cyx3705/2025-002/b-Office/对比分析报告.pptx

标题

·

制作人 王小明

Prepared by AIR-Tech@ 11/4/2025 3:30:31 PM

## Slide 2

目录

主要设计的对比

设计的优势

设计的劣势

## Slide 3

主要设计对比

·

Prepared by AIR-Tech@ 11/4/2025 3:30:32 PM

## Slide 4

主要设计对比

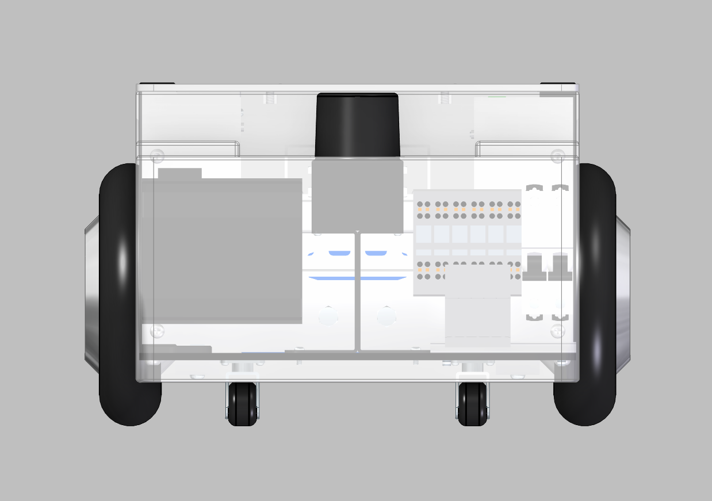
[picture p3: figure]
图片包含 游戏机, 电脑, 桌子, 街道 AI 生成的内容可能不正确。
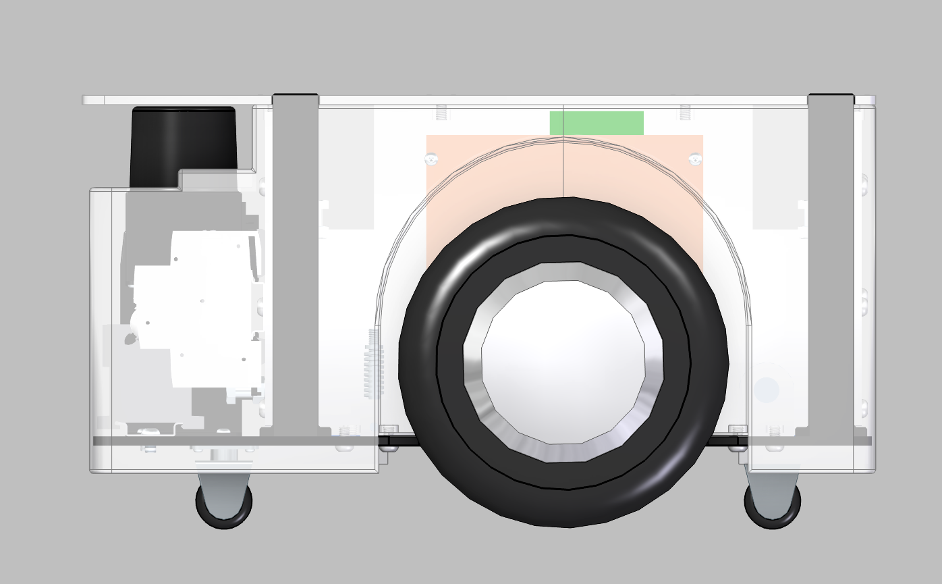
[picture p4: figure]
图片包含 游戏机, 照片, 话筒, 镜子 AI 生成的内容可能不正确。

此为小车三维视图与
小车整体样式，
注意：此时外壳设置为透明只是为方便观察到内部设计和样式，方便对比分析，实物使用的是铝合金外壳

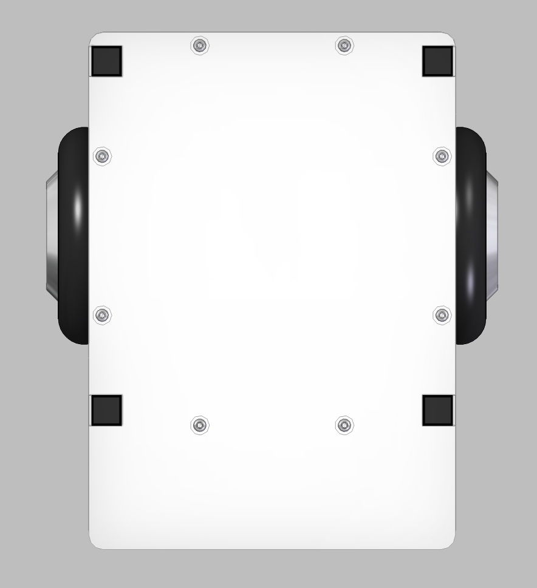
[picture p5: figure]
文本, 白板 AI 生成的内容可能不正确。
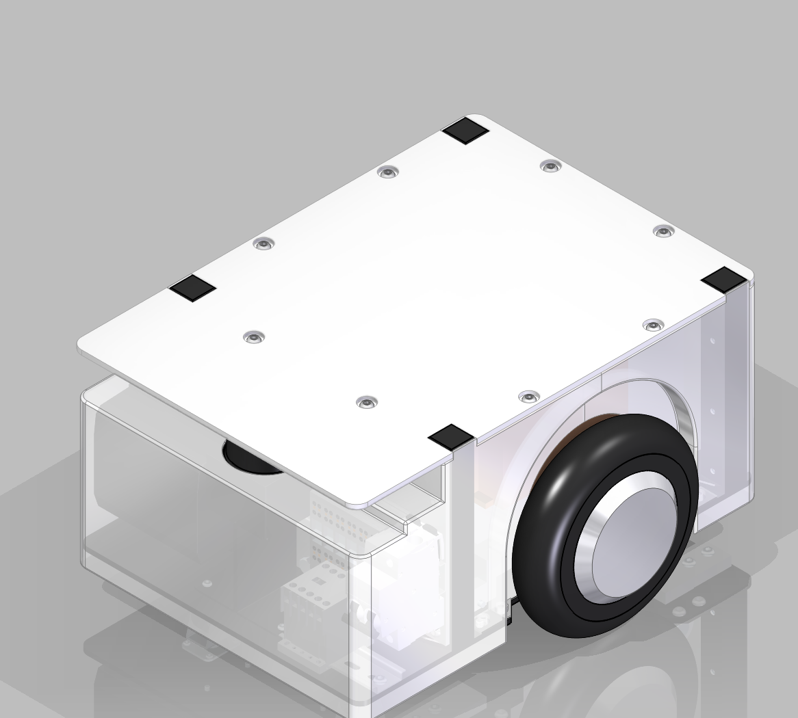
[picture p6: figure]
电子仪器 AI 生成的内容可能不正确。

## Slide 5

主要设计对比

此为小车三维大小图形对比

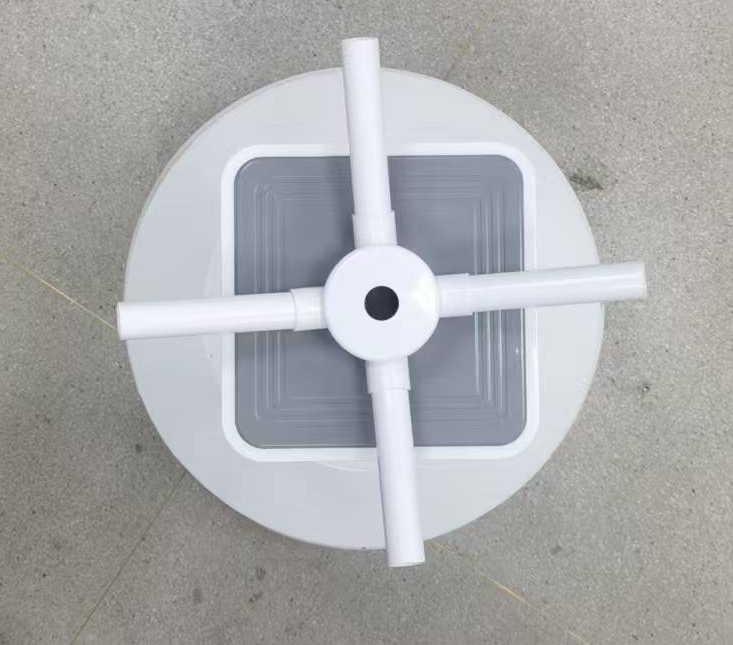
[picture p7: figure]
房间的摆设布局 AI 生成的内容可能不正确。
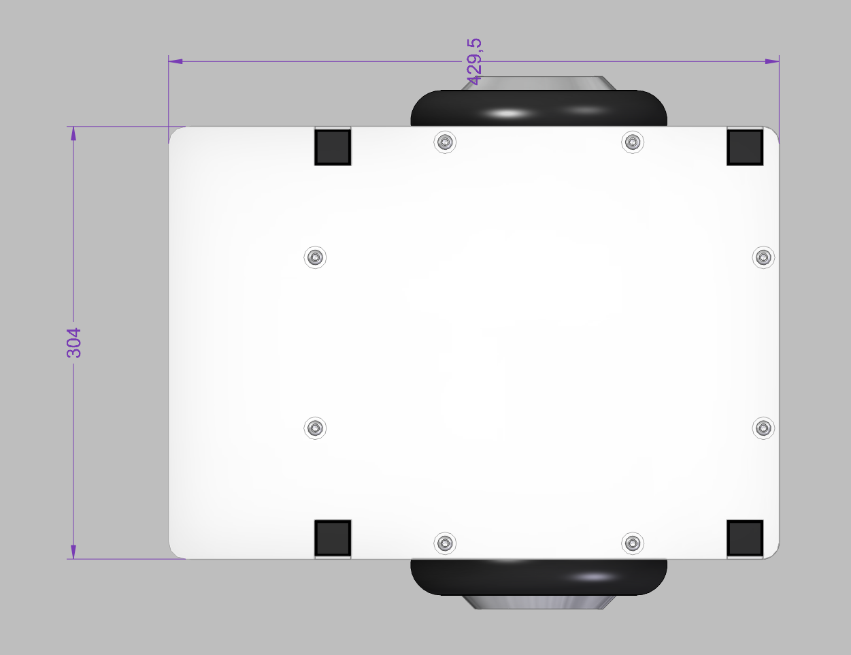
[picture p8: figure]
文本, 白板 AI 生成的内容可能不正确。

500的直径

## Slide 6

主要设计对比

此为小车三维大小图形对比

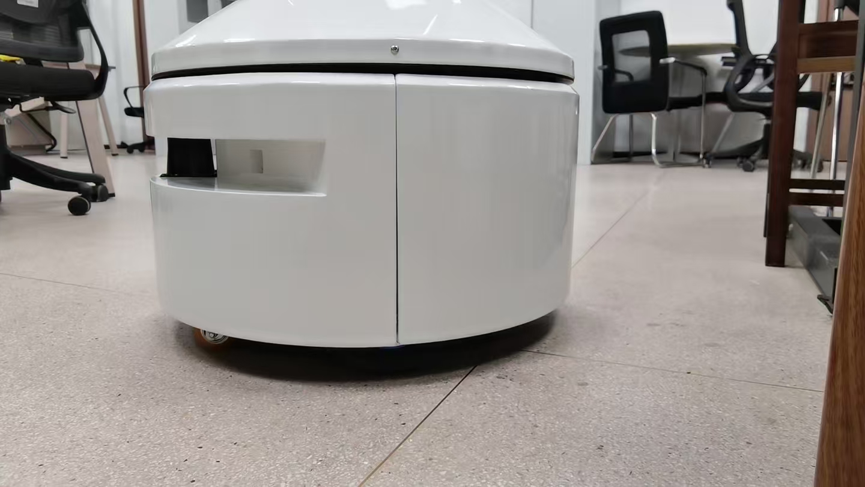
[picture p9: figure]
图片包含 室内, 桌子, 猫, 前 AI 生成的内容可能不正确。
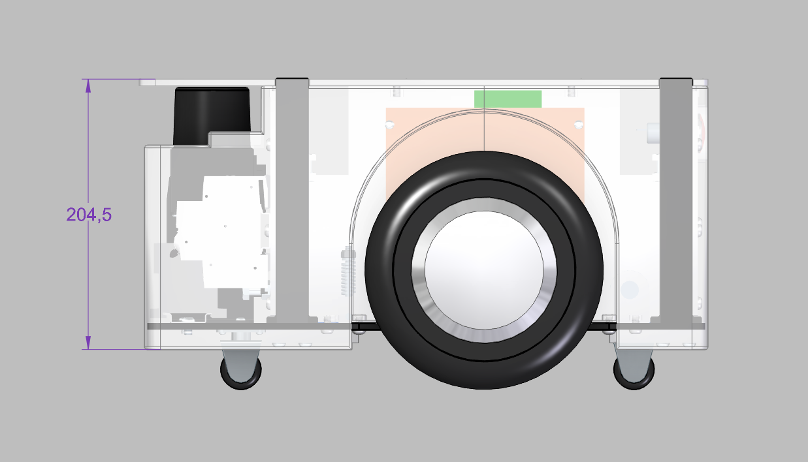
[picture p10: figure]
社交网络的手机截图 AI 生成的内容可能不正确。

250的高

## Slide 7

主要设计对比

此为小车内部结构的对比

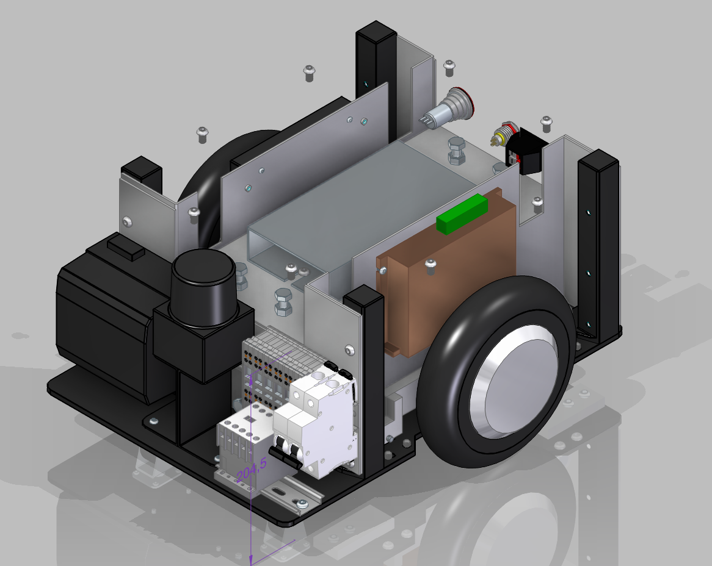
[picture p11: figure]
图片包含 乐高, 玩具, 室内, 桌子 AI 生成的内容可能不正确。

我们设计的布局紧凑结构合理

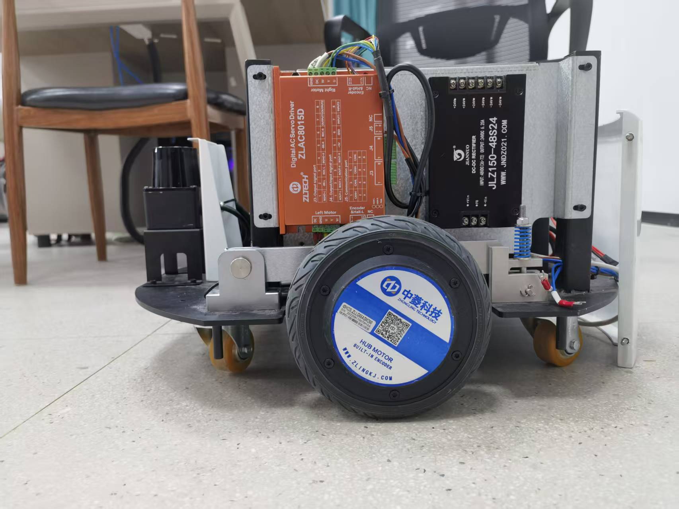
[picture p12: figure]
桌子上放着几个行李箱 AI 生成的内容可能不正确。

原先的较多空间浪费

## Slide 8

主要设计对比

此为小车内部结构的对比

原先的设计使用螺栓进行锁紧并提供纵向拉力，所有力汇集
到螺栓上面，受力非常不合理
我们的设计使用悬挂直接与底板解除传导力，受力合理

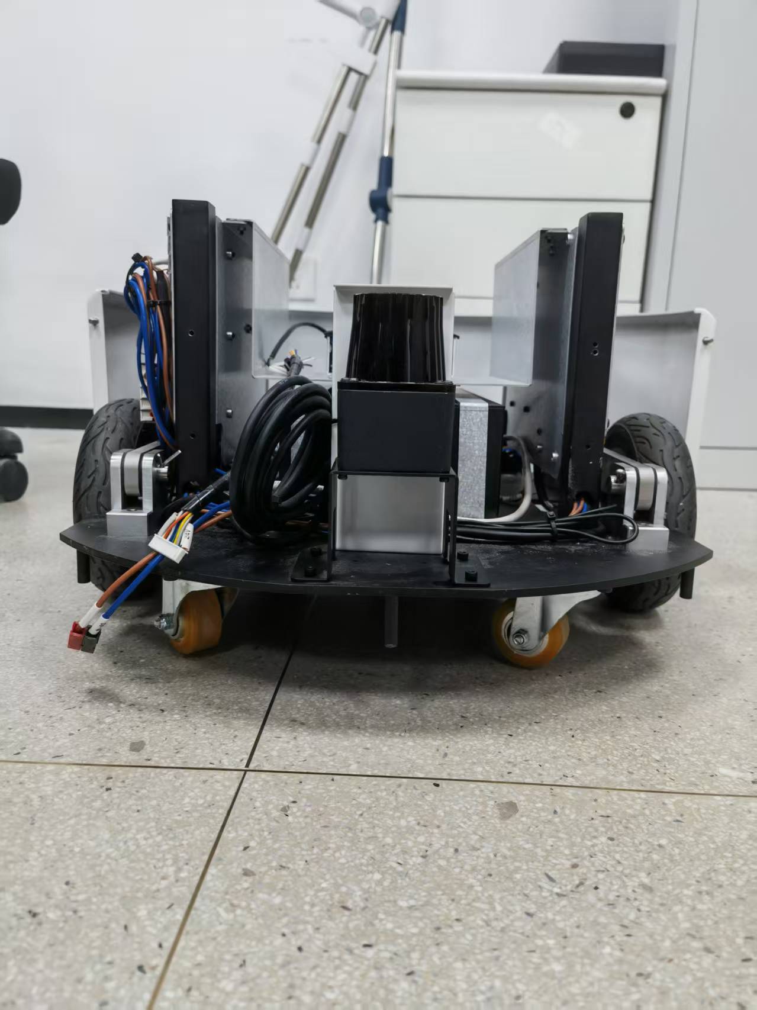
[picture p13: figure]
图片包含 户外, 卡车, 男人, 大 AI 生成的内容可能不正确。
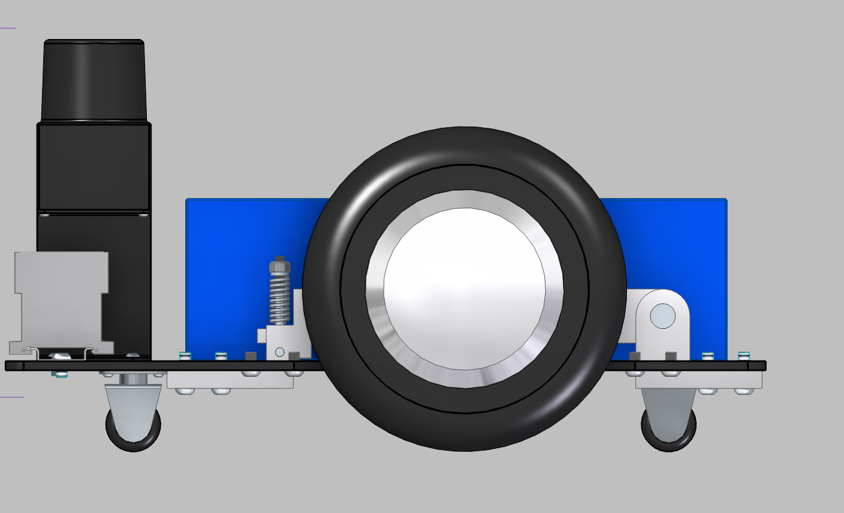
[picture p14: figure]
图片包含 游戏机, 电子, 话筒, 桌子 AI 生成的内容可能不正确。

## Slide 9

主要设计对比

此为小车顶部空间利用对比

本设计底部螺丝直接与外壳相连接，总体安装比右图红圈标注的地方的螺母连接更易连接（本设计还有很多有代表性的这类设计，只是使用这一典型设计做声明）

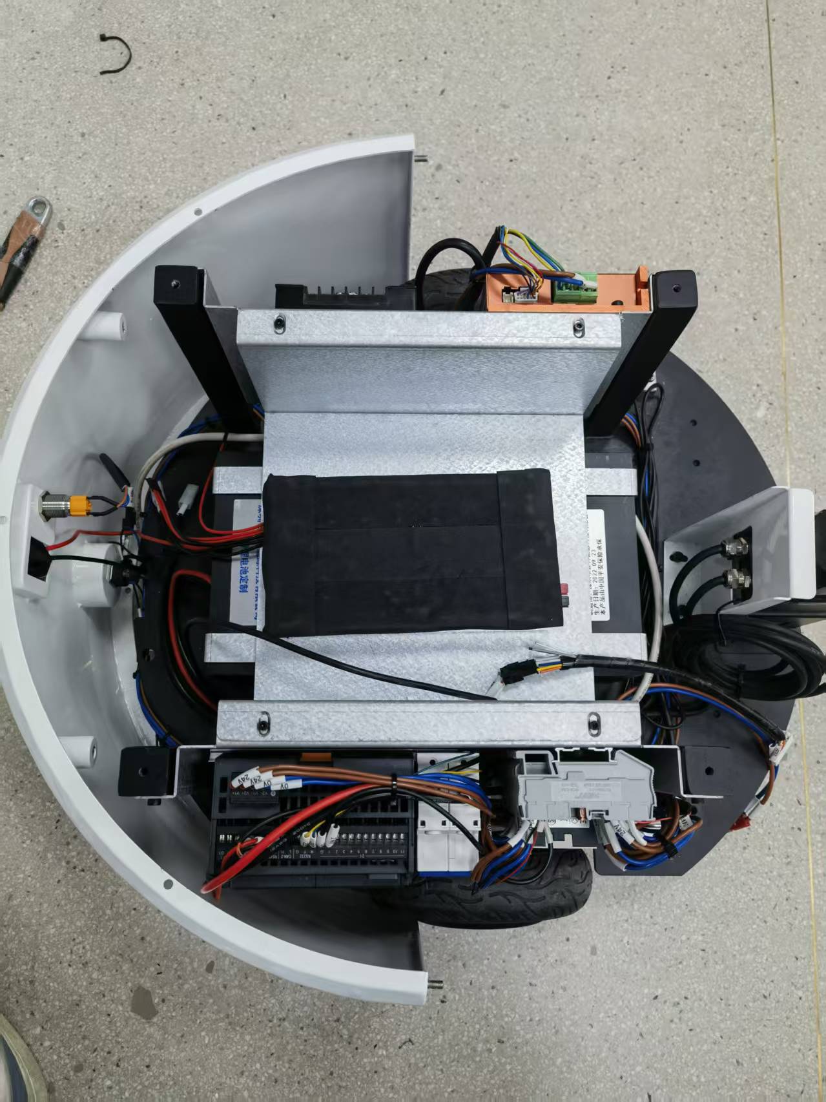
[picture p15: figure]
桌子上的自行车 AI 生成的内容可能不正确。
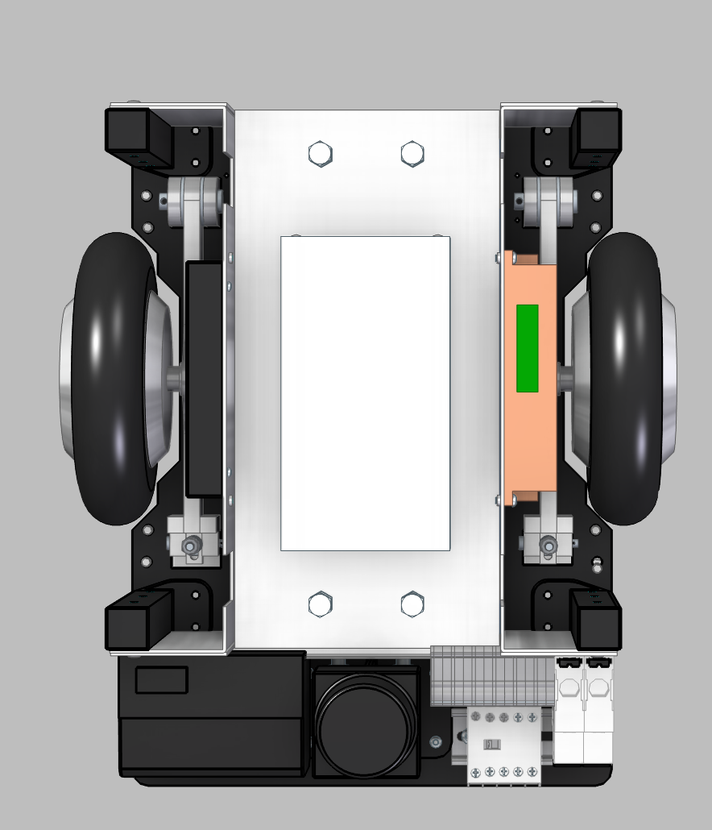
[picture p16: figure]
图形用户界面 AI 生成的内容可能不正确。
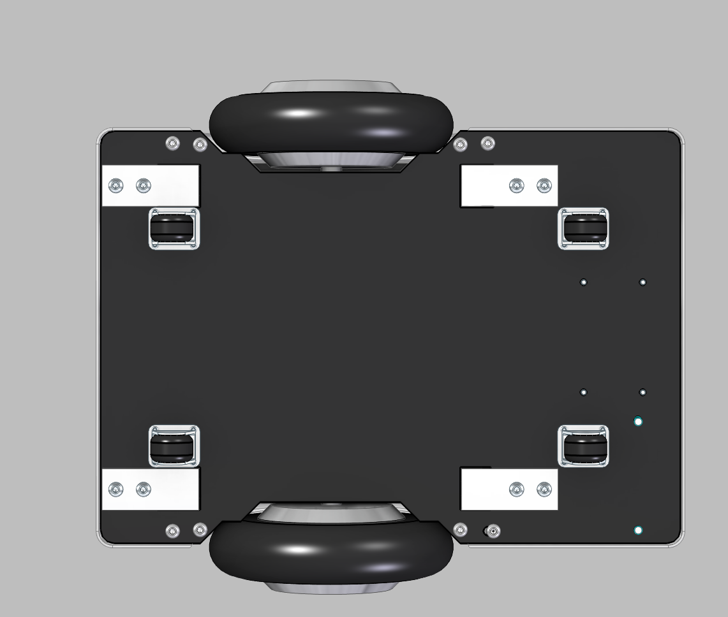
[picture p17: figure]
图形用户界面 AI 生成的内容可能不正确。

## Slide 10

设计的优势

·

Prepared by AIR-Tech@ 11/4/2025 3:30:32 PM

## Slide 11

设计的优势

1.根据前面的对比已经知道本设计使用的结构使得整体体积下降1.8倍250*250*250*3.14/(430*304*200)=1.8

2.不仅螺栓受力更合理，而且支撑架的受力同样更合理
悬挂的顶部直接是支撑架，底盘不传导车体本身重量以外的其他力是非承载式底盘。

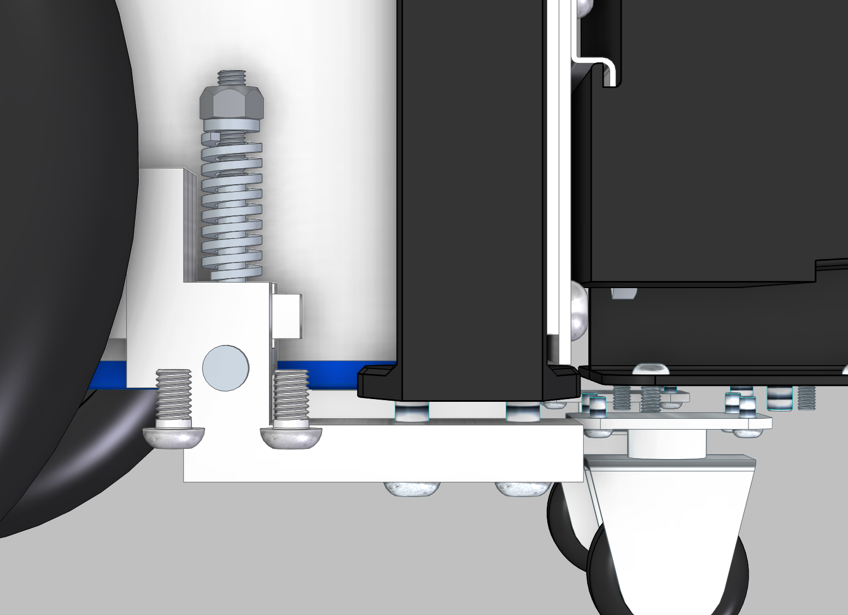
[picture p18: figure]
图形用户界面 AI 生成的内容可能不正确。

## Slide 12

设计的优势

2.本设计中电池是直接使用支撑螺丝固定在板材上面的而非使用钢条绑定在底盘上面，这样的设计更加简单便宜因为固定螺栓使用的是标准件，并且整体受力是多个方向的支持力比原先使用支持力和摩擦力的合力要更好。整车的一体性要明显更好！

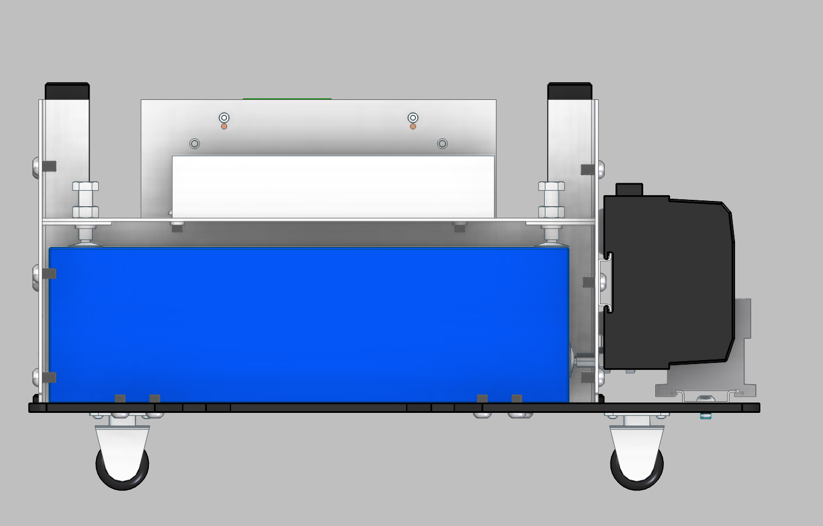
[picture p19: figure]
图形用户界面 AI 生成的内容可能不正确。

## Slide 13

设计的劣势

·

Prepared by AIR-Tech@ 11/4/2025 3:30:32 PM

## Slide 14

设计的劣势

2.本设计唯一相比原先的设计的劣势是，由于需要压缩体积，导致雷达的扫描范围有小部分减少，但基本上不影响使用，本车的雷达也是完全暴露的。

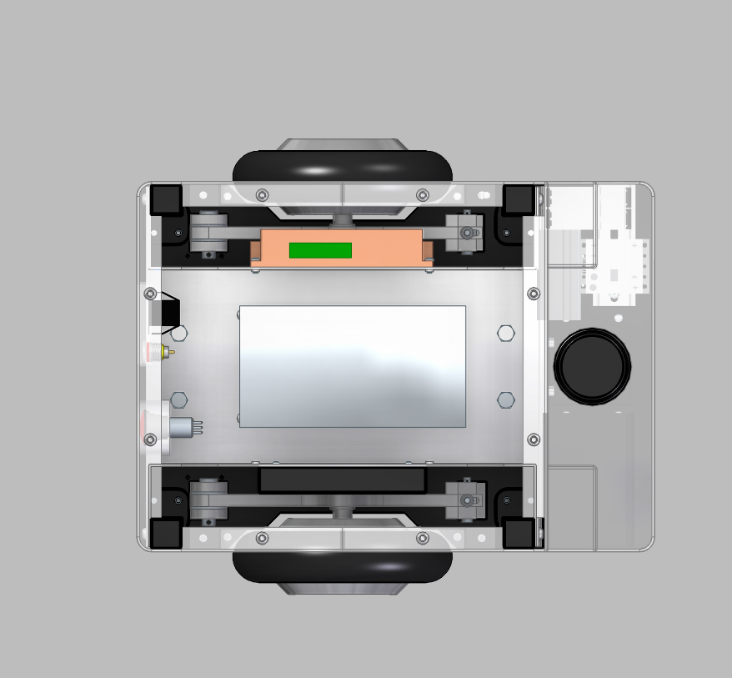
[picture p20: figure]
图片包含 游戏机, 卡车, 男人, 床 AI 生成的内容可能不正确。

盲区
