cyx3705/2025-002/b-EPLAN/AGV.edb/Images/2.png

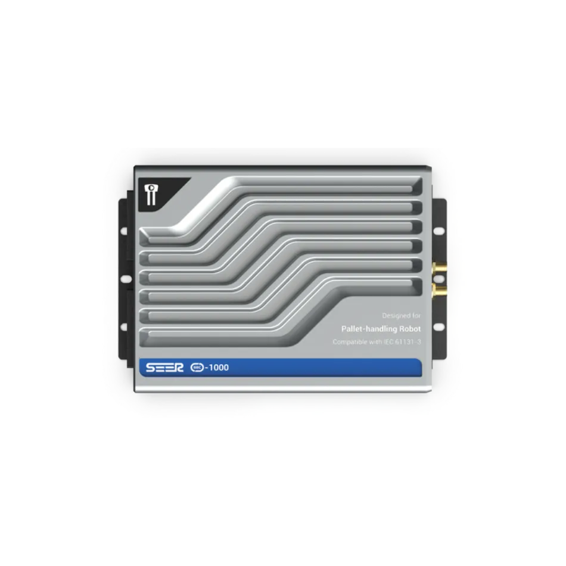
b-EPLAN/AGV.edb/Images/2.png
