cyx3705/2025-002/b-EPLAN/AGV.edb/Images/CRC3000.png

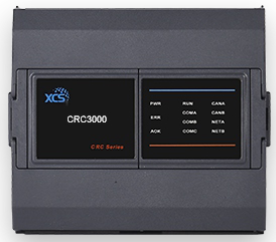
b-EPLAN/AGV.edb/Images/CRC3000.png
