cyx3705/2025-002/b-Office/BOM表.xlsx

Sheet: Revision History
Revision 版本 | Description 变更描述 | Date 变更日期 | Updated BY 变更人 | Remarks 备注
1.01 | 更换仙工的控制器，增加接口转换模块 | 2025-11-20 | 夏姜楠
1.02 | 删除冗余变频器，修改轮毂选型,完善设备完整度（新增急停按钮和启动按钮） | 2025-11-28 | 夏姜楠

Sheet: BOM模板
 | Product Name 成品名称 |  | DOC. Number 文件编号 |  | Rev. 版本号 |  |  | Updated BY 更新人 |  | Checked BY 审核人 |  | Approved BY 批准人
 |  |  | BOM-503TWM0203 |  | 1.02
 |  |  |  |  |  |  |  | Date 日期 |  | Date 日期 |  | Date 日期
 |  |  | Initial Date 初版日期
Item 序号 | 文档号 | Description 名称 | Specification 参数描述 | Manufacturer 制造商 |  | RoHS 有毒 元素 控制 | QTY 数量 | Unit 单位 | Substitute P/N 替代料P/N | Remarks 备注 | EPDM Auto EPDM自动导出 | Optimized 优选等级 | Unit Price 单价(RMB) | Subtotal 合计(RMB)
 |  |  |  | Model No. 型号 | Brand 品牌
1 | N2531-2113 | 变压器 | input:48VDC output:24VDC 6.25A | JLZ150-48S24 | JIANNUO |  | 1
1 | N2531-2112 | 伺服驱动器 | input:48VDC output:均值15VDC 峰值30A | ZLAC8015D | ZLTECH |  | 1
2 | N2531-1411 | 雷达 | 2D导航激光 | H1E0-02C | 仙工 |  | 1
3 | N2531-0121 | 后外壳 |  |  |  |  | 1
4 | N2531-0122 | 前外壳 |  |  |  |  | 1
5 | N2531-0123 | 顶板 |  |  |  |  | 1
6 | N2531-1111 | 电池 | 标称电压：48V 充电电压：54.6V 标称容量：20Ah 放电电流：<=30A | LS-DL48-20C | 深圳市锂神能源科技有限公司 |  | 1
7 | N2531-1121 | 底盘主体 |  |  |  |  | 1
8 | N2531-1211 | 6.5寸轮毂带编码器机器人轮毂伺服 | M170 48V 250W 4N.m IP65 | ZZLG65ASM250 V3.0 | 中菱科技 |  | 2
9 | N2531-1221 | 前桥 |  |  |  |  | 2
10 | N2531-1222 | 后桥 |  |  |  |  | 2
11 | N2531-1223 | 梁 |  |  |  |  | 2
12 | N2531-1311 | 轮毂架 |  |  | RichLand |  | 4
13 | N2531-1312 | 辅助轮 |  |  | RichLand |  | 4
14 | N2531-2111 | 电箱din导轨300 | 296mm |  |  |  | 1
15 | N2531-2121 | 安装板 |  |  |  |  | 1
16 | N2531-2122 | 架子 |  |  |  |  | 1
17 | N2531-2123 | 挡板 |  |  |  |  | 1
18 | N2531-2221 | 上安装板 |  |  |  |  | 1
19 | N2531-0111 N2531-2115 N2531-1513 N2531-2211 | 内六角平圆头螺钉 | M6*10 | GBT70.2-2015 |  |  | 33
20 | N2531-1412 N2531-2117 | 内六角平圆头螺钉 | M4*10 | GBT70.2-2015 |  |  | 6
21 | N2531-2116 | 内六角平圆头螺钉 | M3*10 | GBT70.2-2015 |  |  | 2
22 | N2531-1313 N2531-1413 | 内六角平圆头螺钉 | M3*6 | GBT70.2-2015 |  |  | 20
23 | N2531-2400 | 紧固螺丝组 | M8*50 |  |  |  | 6
24 | N2531-1212 | 销 | M5*34 |  |  |  | 2
25 | N2531-1213 | 大垫圈 | D30 d10 |  |  |  | 4
26 | N2531-1214 | 小垫圈 | D10 d6 |  |  |  | 4
27 | N2531-1215 | 平头圆柱销 | M10*36 |  |  |  | 2
28 | N2531-1216 | 六角锁紧螺母 | M6 | GBT6184-2000 |  |  | 2
29 | N2531-1217 | 内六角平圆头螺钉 | M6*20 | GBT70.2-2015 |  |  | 8
30 | N2531-1225 | 减震器 |  |  |  |  | 2
31 | N2531-1218 | 弹簧 | D10 d5 H20 |  |  |  | 2
32 | N2531-1421 | 雷达安装板 |  |  |  |  | 1
33 | N2531-211B | 接触器 | TeSys K 直流控制三极接触器, 12A, 24 V DC | LP1K1210DB | 施耐德 |  | 1
34 | N2531-1512 | 电箱din导轨100 |  |  |  |  | 1
35 | N2531-2118 | 移动机器人导航控制器 |  | SRC-880-t | 仙工 |  | 1
36 | N2531-211A | 接线端子 |  | PT2.5-QUATTRO灰色 |  |  | 12
37 | N2531-2119 | 空开 |  | IC60a | 施耐德 |  | 2
38 | N2531-211C | RS-232/485转CAN BUS协议转换器 | RS232/485转CANBUS | UT-2506A | 宇泰 |  | 1
39 | N2531-211D | 语音提示器 |  |  |  |  | 1
40 | N2531-211E | 急停开关 |  | YJ-LA16-11ZS 红 | 一佳 |  | 1
41 | N2531-211F | 开关按钮 |  | LB16A/19A铝氧化 | 蓝波 |  | 1
42 |  | 触摸屏 | 384*247 | TPC1570Gn | 昆仑通态
43
44
45
46
注： |  | 为加工件
 |  | 为采购件
