cyx3705/2025-002/b-Module-GE/0000-DJJ-12-5.stp

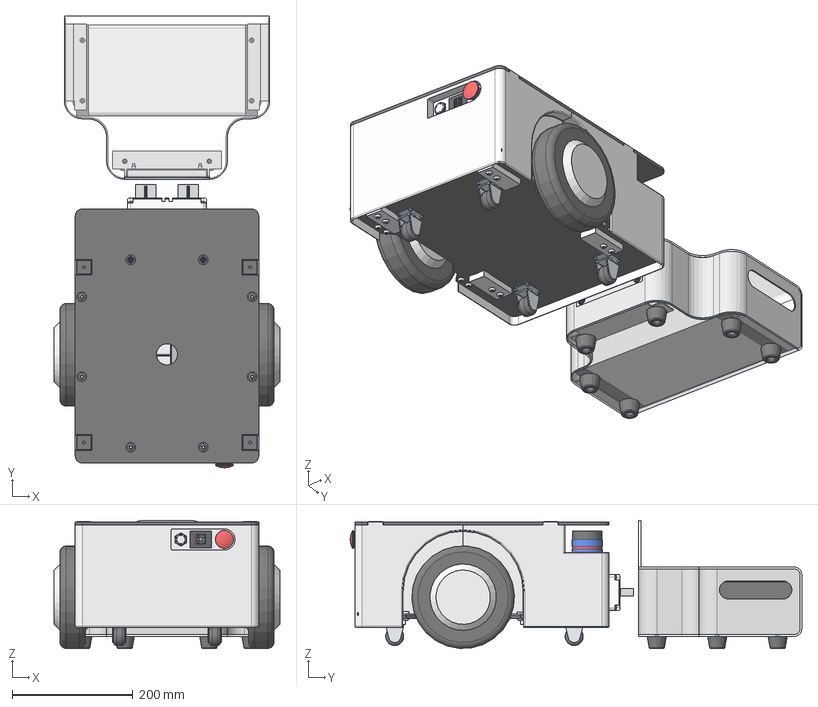
[picture p38: CAD file, 2026-09-21]
b-Module-GE/0000-DJJ-12-5.stp
374.0 x 747.5 x 212.0 mm
1311-謫嘎 x 4
1312-謫 x 4
1313-内六角平圆头螺钉-GBT70.2-20 x 16
1221-ǰ x 2
1222-綴Э x 2
1223-褽 x 2
1217-内六角平圆头螺钉-GBT70.2-201 x 8
1224-熬涾 x 2
1213-湮菜 x 4
1212-种 x 2
1214-苤菜 x 4
1211-轮瓙 x 2
1218-粟 x 2
1216-1型全金属六角锁紧螺母-GBT618 x 2
1215-ﾆｽﾍｷﾔｲﾄ x 2
1121-菁攫
0111-内六角平圆头螺钉-GBT70.2-201 x 18
1111-萇
2121-假蚾 x 2
2123-結 x 2
2122-ｼﾜntationRefs x 4
SB105175_3D-SOFTWARE_COLOUR
2115-内六角平圆头螺钉-GBT70.2-201 x 12
2125-PT2.5-QUATTRO灰色（万特弗t x 12
2125-PT2.5-QUATTRO灰色隔断板（万 x 6
2119-諾羲 zz x 2
2111-电箱din导轨
2221-奻假
2211-内六角圆柱头螺钉-GBT70.1-20饳扑 x 6
2214-濘
2213-内六角圆柱头螺钉-GBT70.1-200 x 4
2117-曹揤v褊
2222-濘湛假efs
2212-SRC-1X00-CN
2116-ﾋﾅｷﾇﾋ
2215-内六角圆柱头螺钉-GBT70.1-20T x 2
2216-内六角圆柱头螺钉-GBT70.1-20 x 4
2217-内六角圆柱头螺钉-GBT70.1-20R x 2
0123-ｶ･ntationRefs
0122-ﾇｰﾍ穢Xﾊ
0121-綴俋
0116-内六角平圆头螺钉-GBT70.2-201 x 4
0112-YJ-LA16-11ZS
0115-323769099450A横向刷板9
0113-带卡胶壳-147
0114-懦疏LB16
0221-菁
0211-原装充电UY1
0212-脚氶拤 x 4
0222-旳啣
0213-内六角圆柱头螺钉-GBT70.1-200 x 6
IFCBUILDINGELEMENTPROXY.ifc
0214-内六角圆柱头螺钉-GBT70.1-200 x 4
