cyx3705/2025-002/b-EPLAN/AGV.pdf

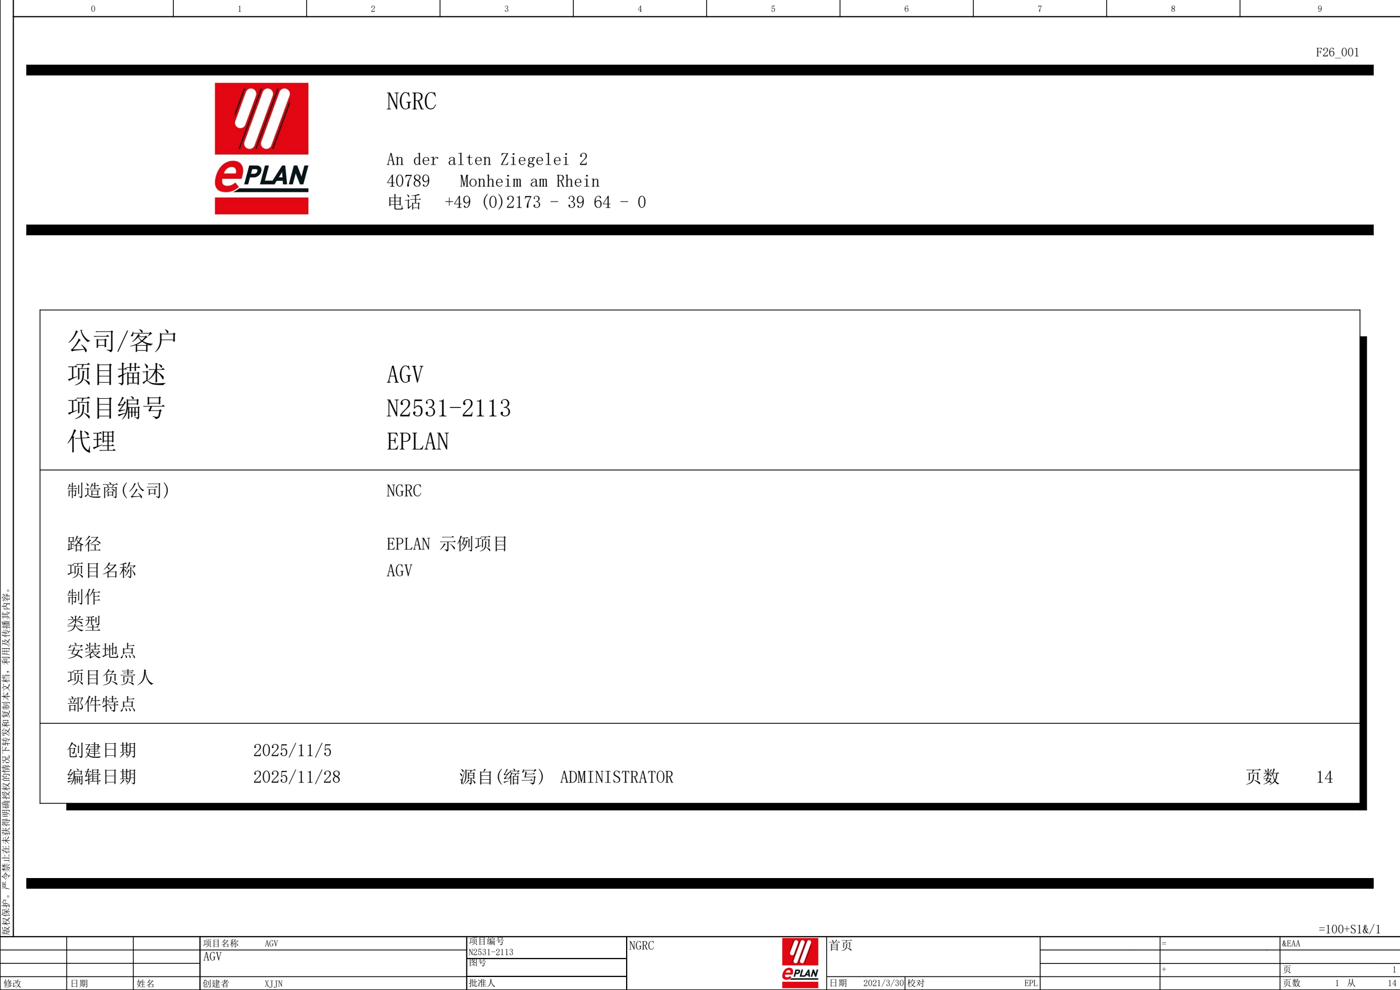
[picture p40: figure]
AGV; EPL 1; NGRC; &EAA; 批准人; 项目名称; 项目编号; 创建者; XJJN; 版权保护。严令禁止在未获得明确授权的情况下转发和复制本文档，利用及传播其内容。; 项目描述; 编辑日期; 创建日期; EPLAN 示例项目; ADMINISTRATOR; 部件特点; An der alten Ziegelei 2; 制造商(公司); 项目负责人; 安装地点; EPLAN; Monheim am Rhein

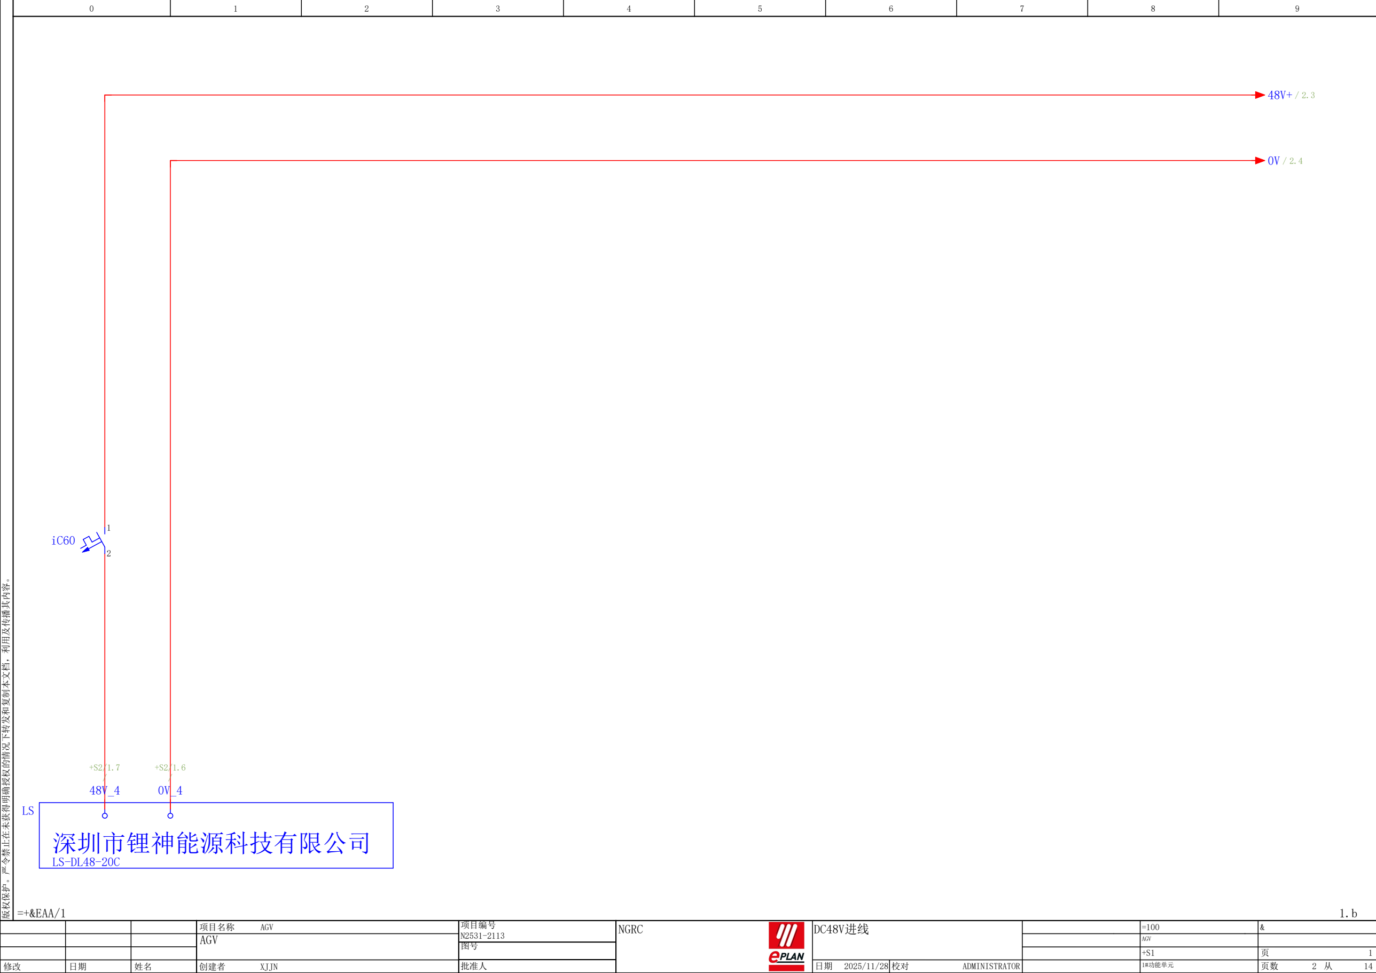
[picture p41: figure]
=+&EAA/1; ADMINISTRATOR; DC48V进线; 1#功能单元; 版权保护。严令禁止在未获得明确授权的情况下转发和复制本文档，利用及传播其内容。; 深圳市锂神能源科技有限公司

ES-7-5

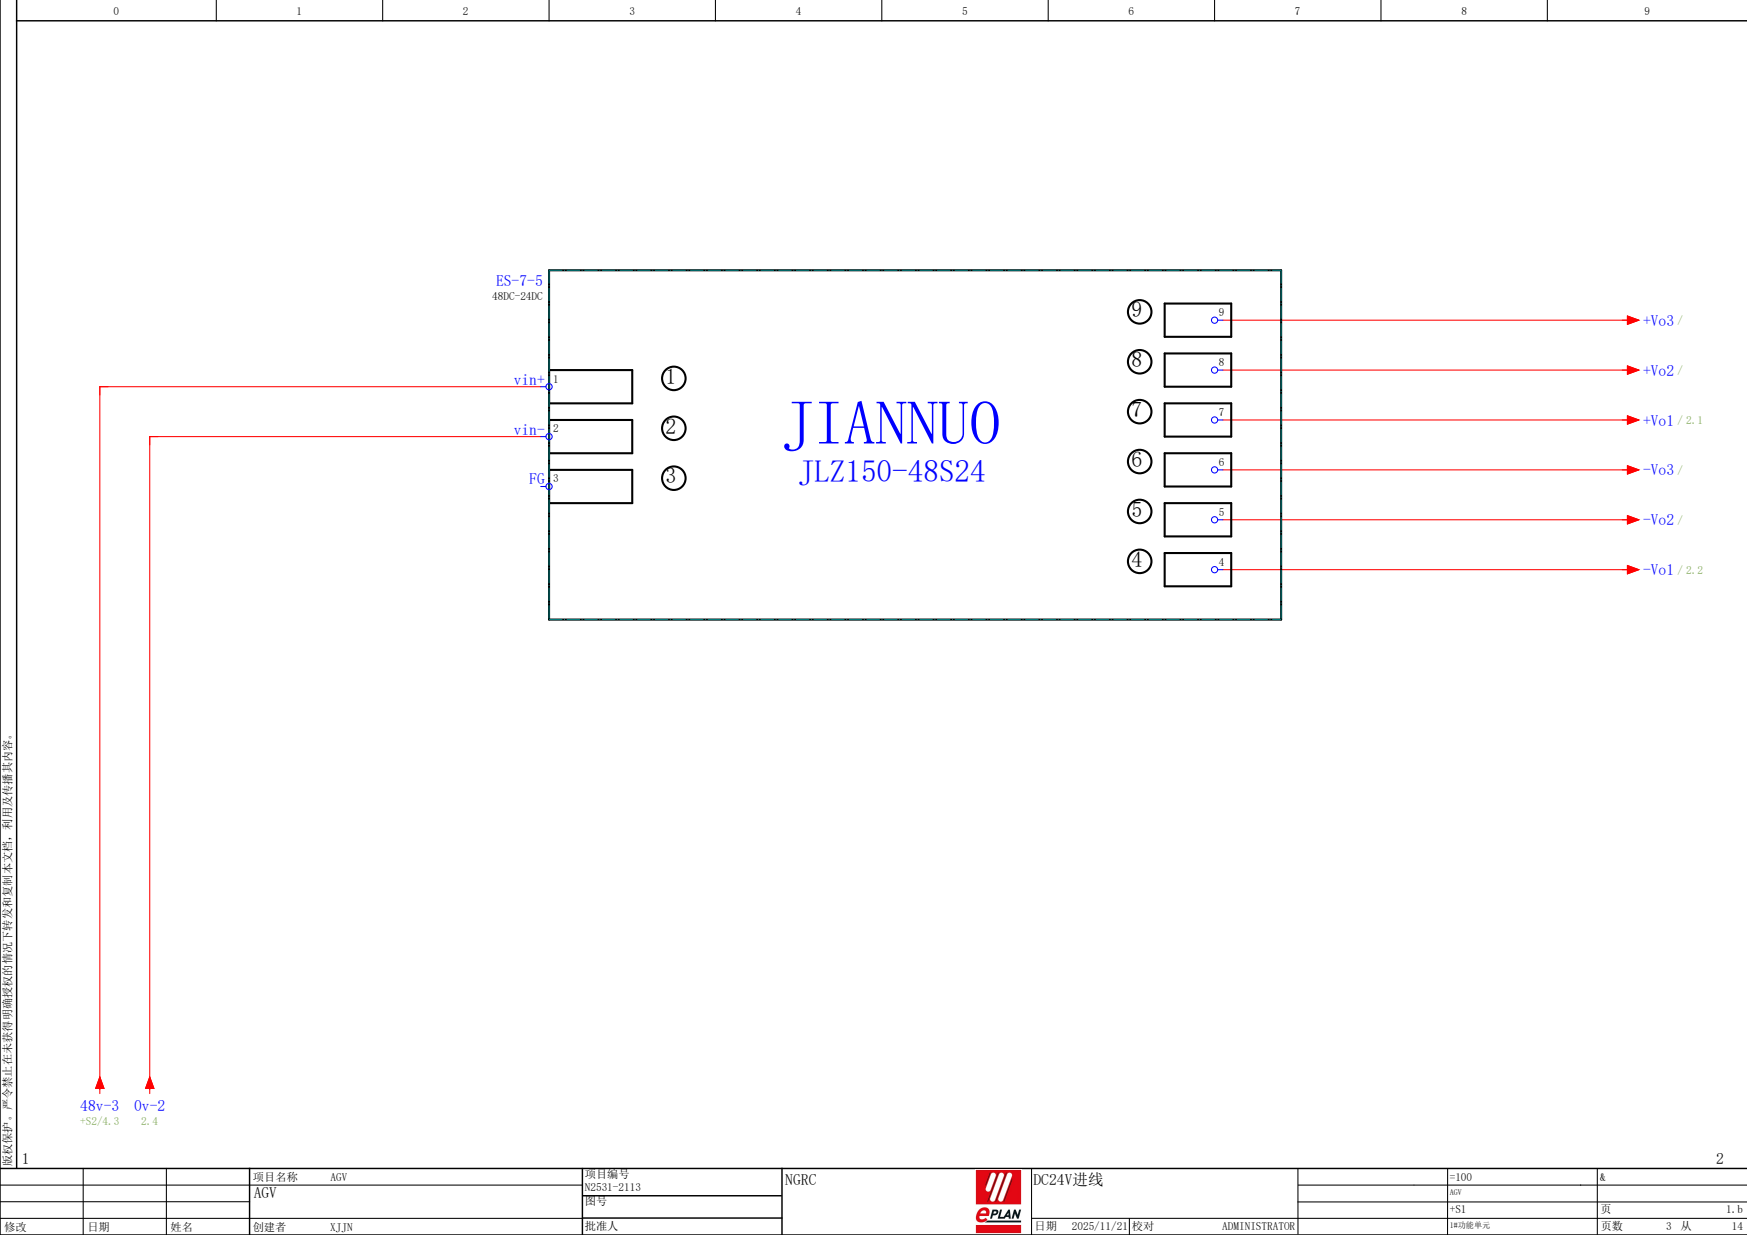
[picture p42: page 3]
ADMINISTRATOR 1; DC24V进线; JLZ150-48S24; JIANNUO; vin+; vin-

版权保护。严令禁止在未获得明确授权的情况下转发和复制本文档，利用及传播其内容。

48V-4

0V-4

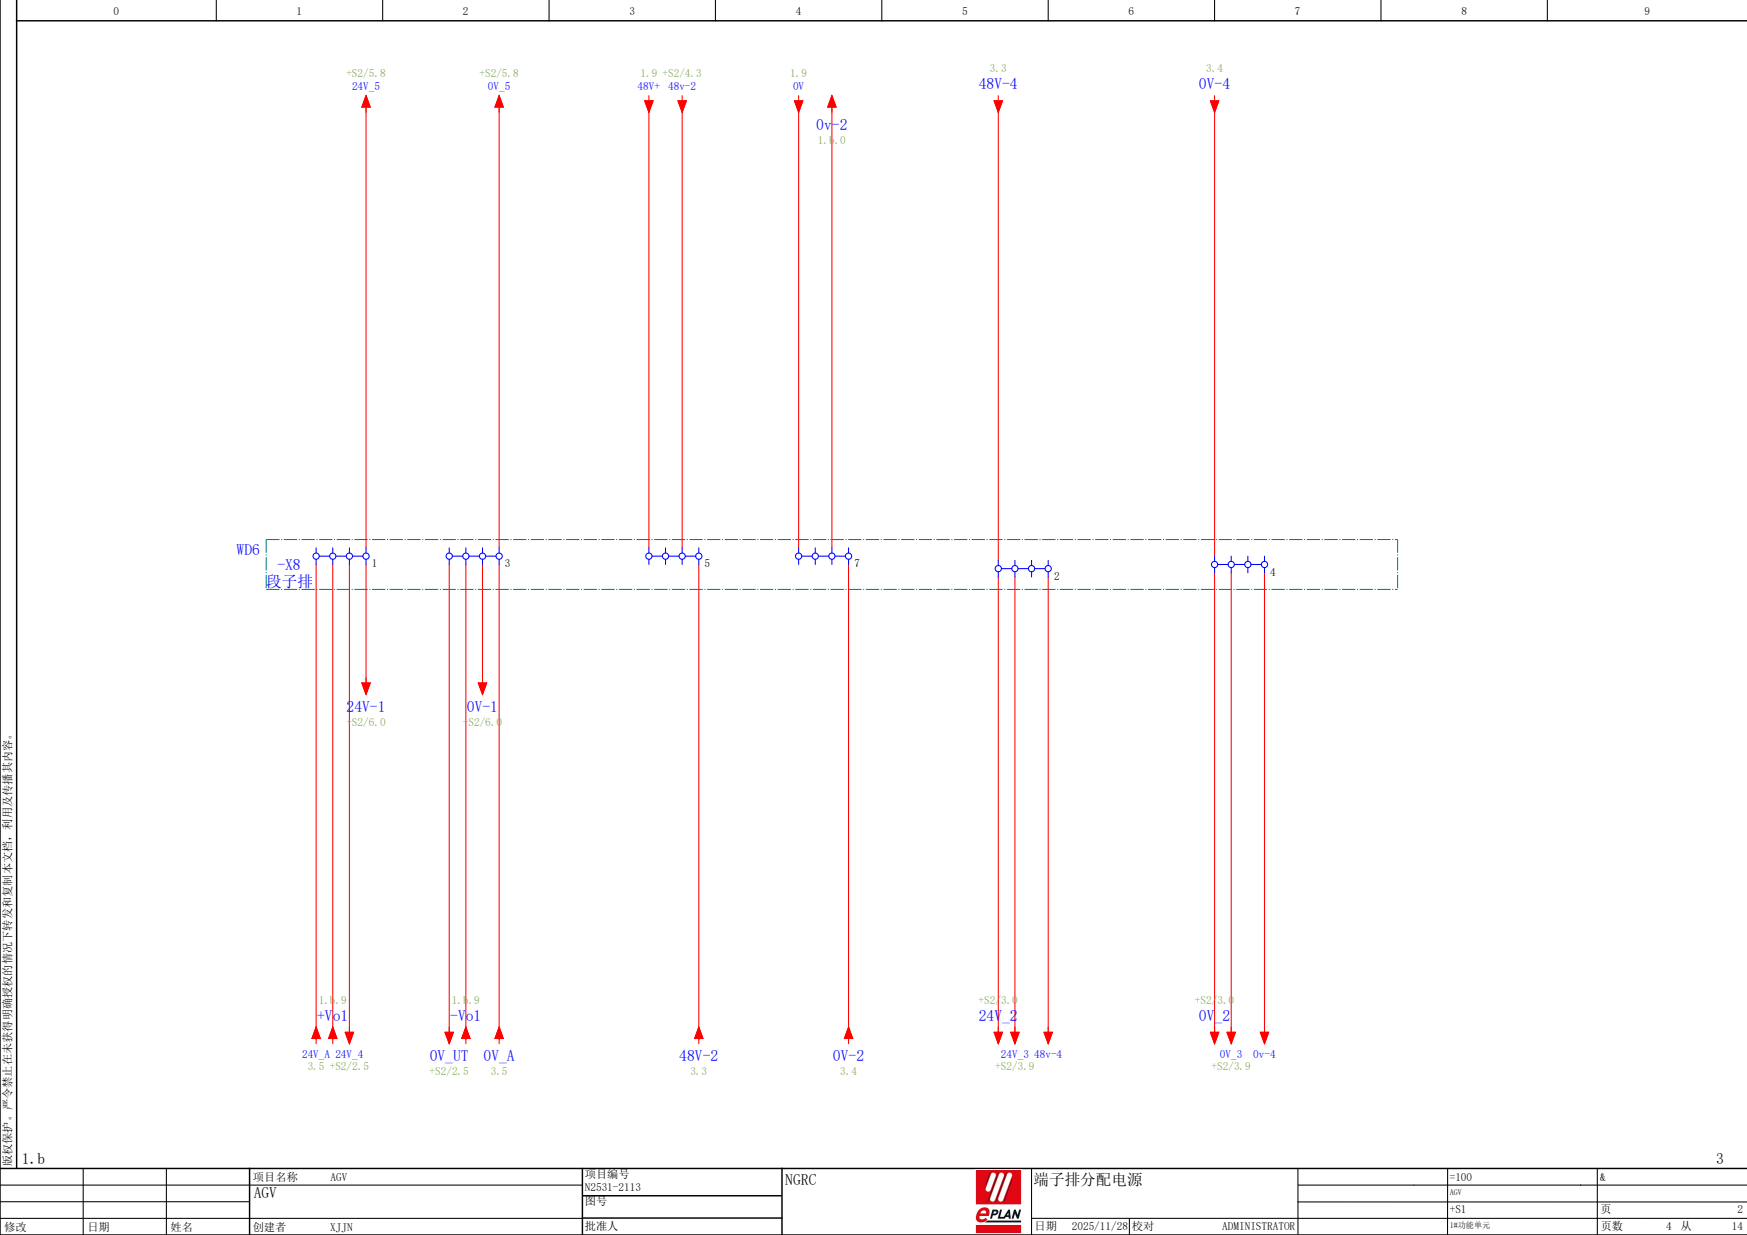
[picture p43: page 4]
端子排分配电源; 段子排

版权保护。严令禁止在未获得明确授权的情况下转发和复制本文档，利用及传播其内容。

48V-2

0V-2

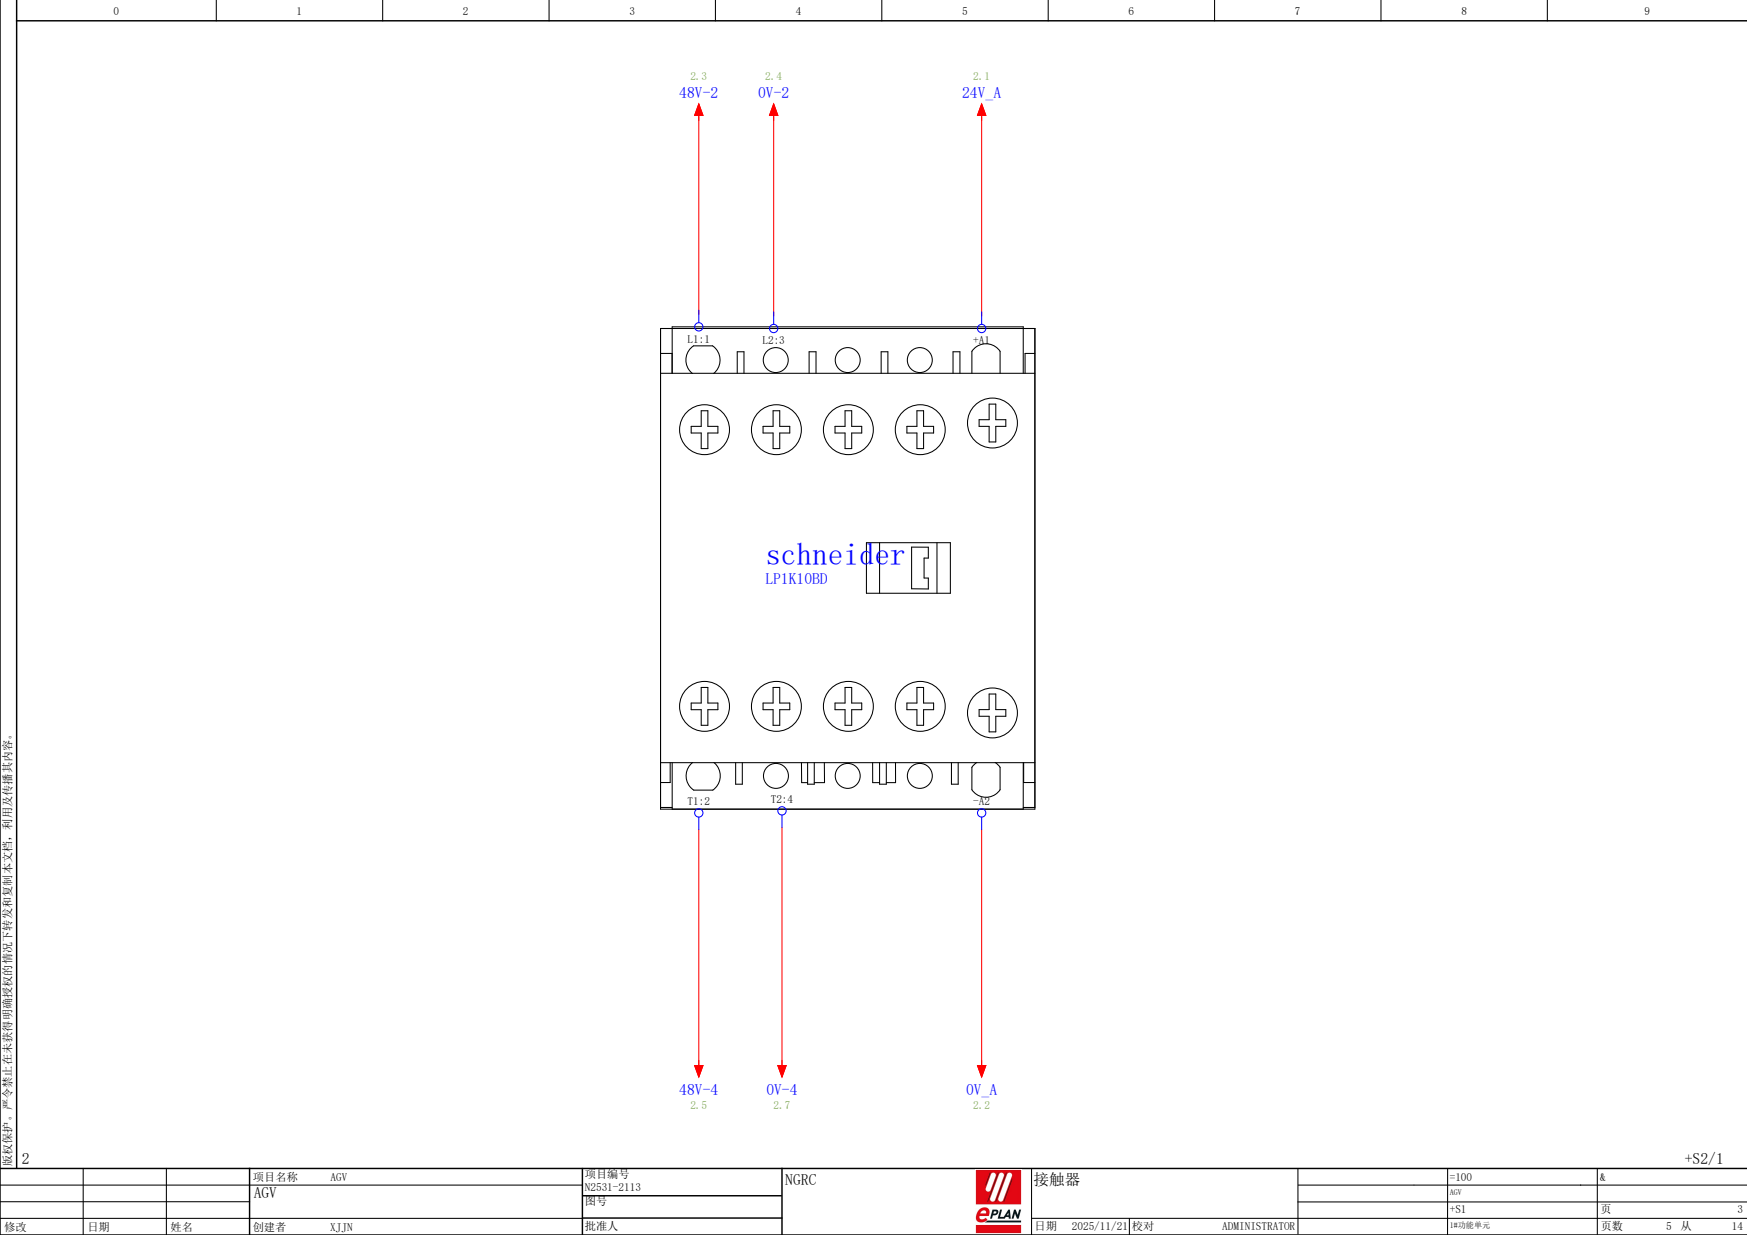
[picture p44: page 5]
ADMINISTRATOR 1; 接触器; schneider

版权保护。严令禁止在未获得明确授权的情况下转发和复制本文档，利用及传播其内容。

48V_4

0V_4

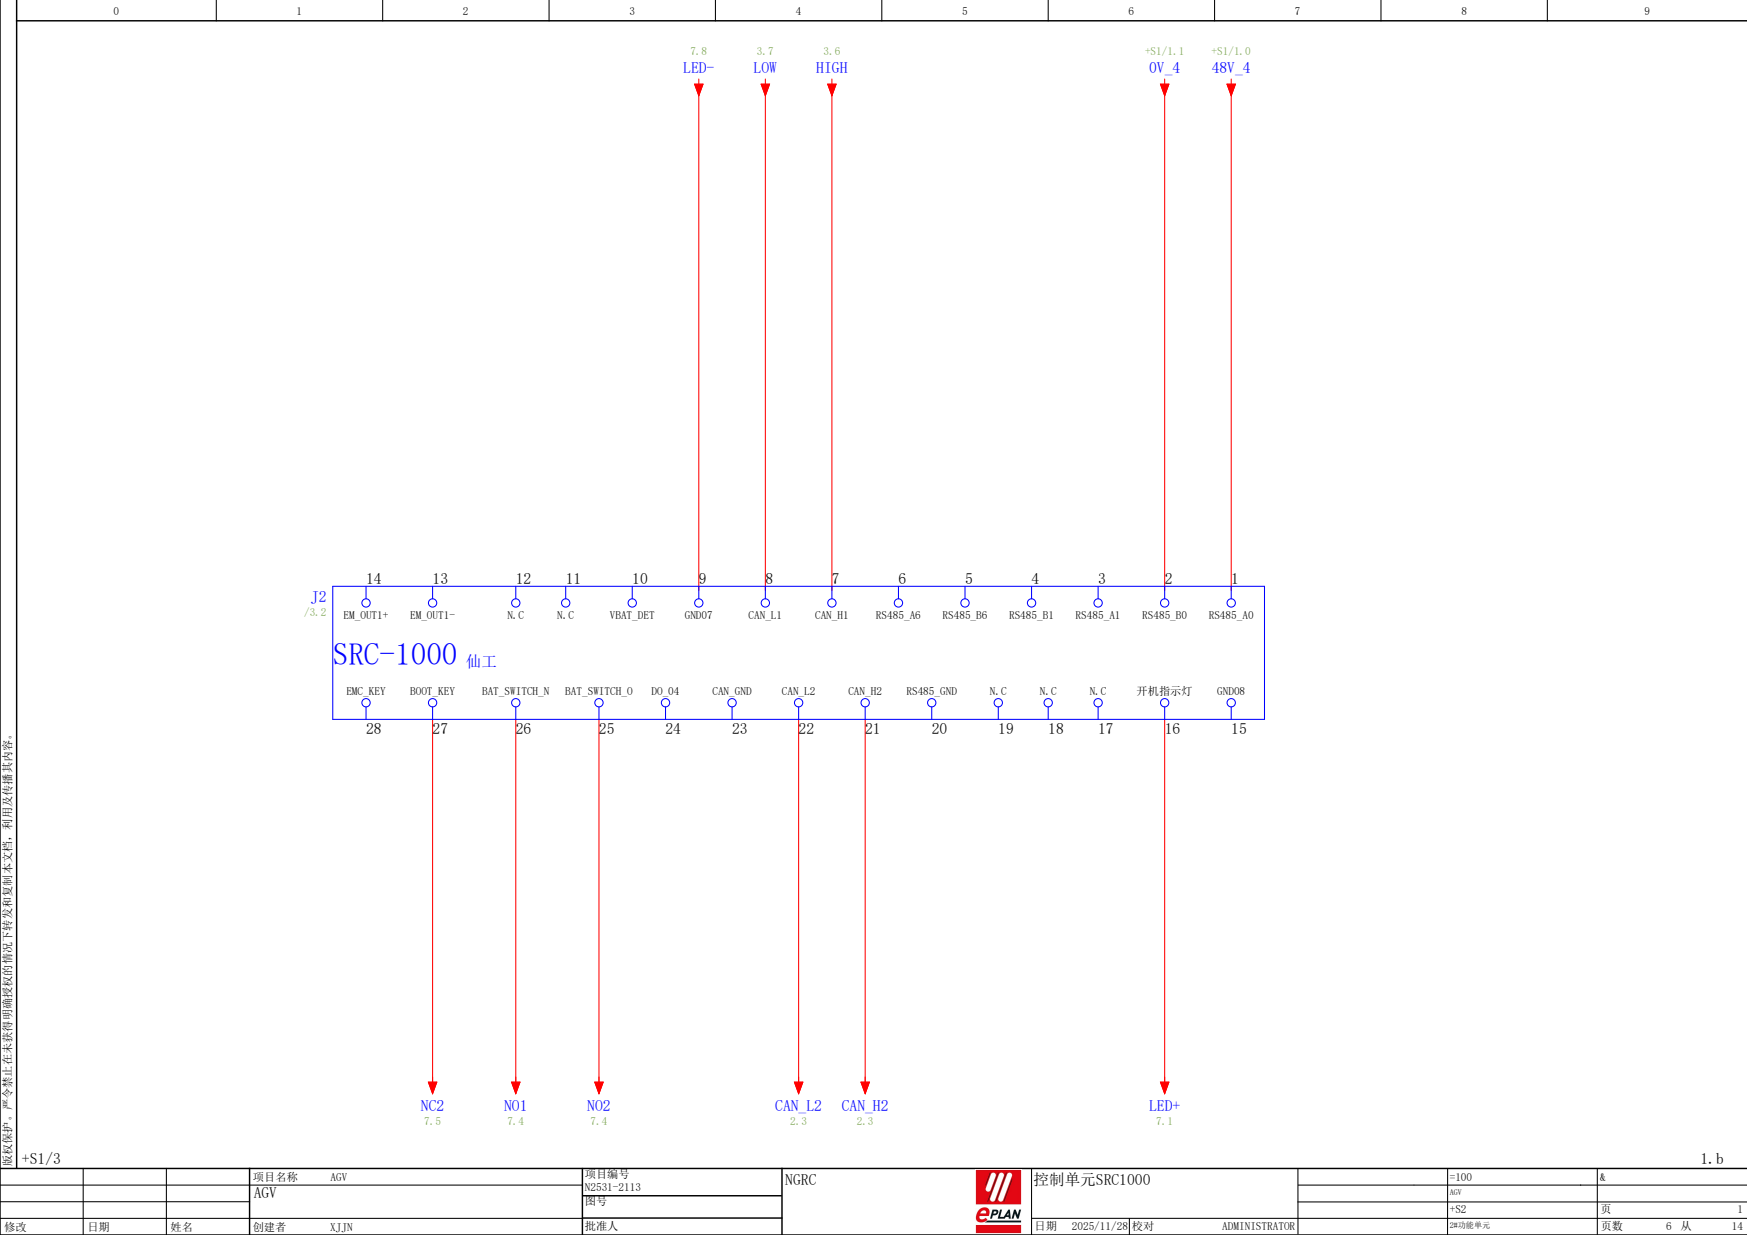
[picture p45: page 6]
控制单元SRC1000; SRC-1000 仙工; GND07; CAN_L1; CAN_H1; GND08; CAN_GND; CAN_L2; CAN_H2; RS485_GND; 开机指示灯; EM_OUT1+; EM_OUT1-; VBAT_DET; EMC_KEY; BOOT_KEY; BAT_SWITCH_N; BAT_SWITCH_O; HIGH; LOW; LED+; LED-

版权保护。严令禁止在未获得明确授权的情况下转发和复制本文档，利用及传播其内容。

## ENABLE

## ALARM

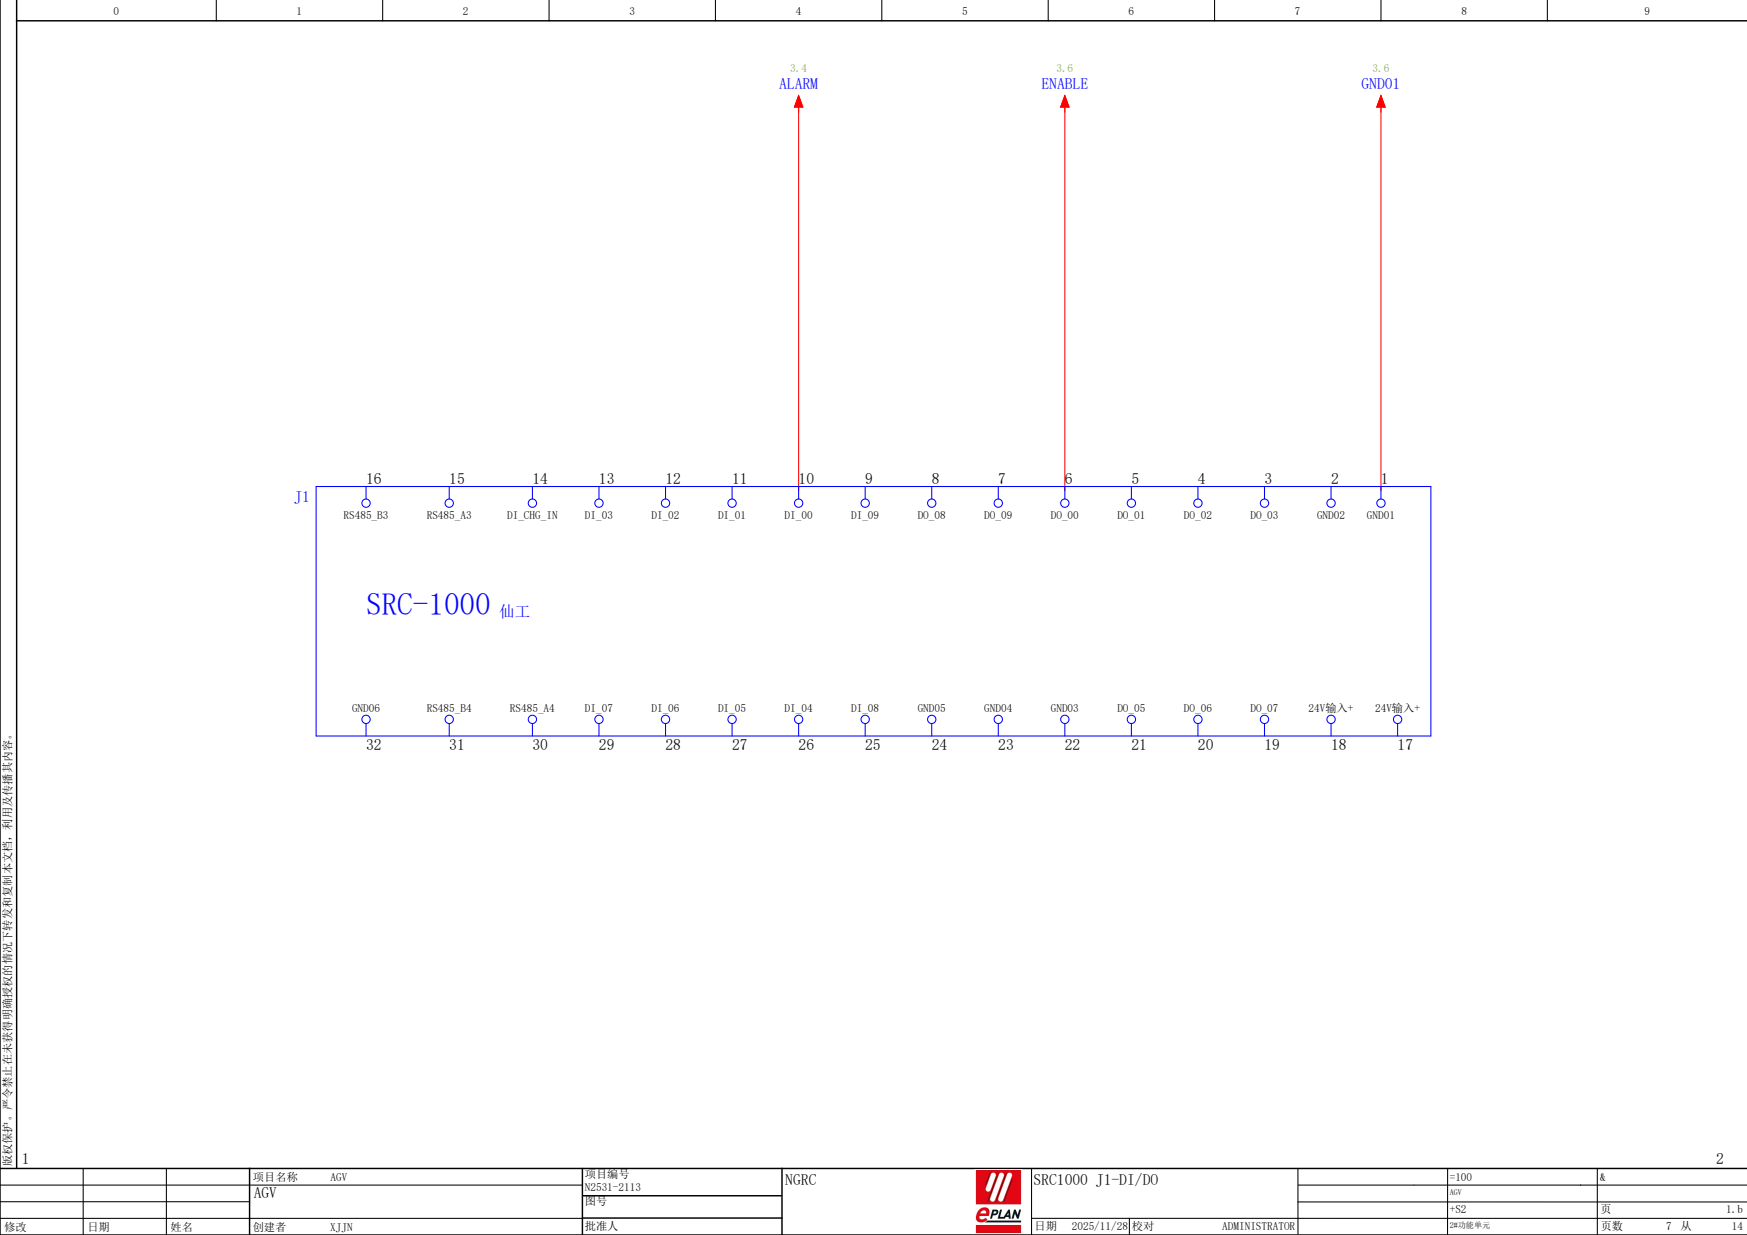
[picture p46: page 7]
SRC1000 J1-DI/DO; SRC-1000 仙工; GND02; GND01; GND05; GND04; GND03; 24V输入+; DI_CHG_IN; GND06

版权保护。严令禁止在未获得明确授权的情况下转发和复制本文档，利用及传播其内容。

232R

232T

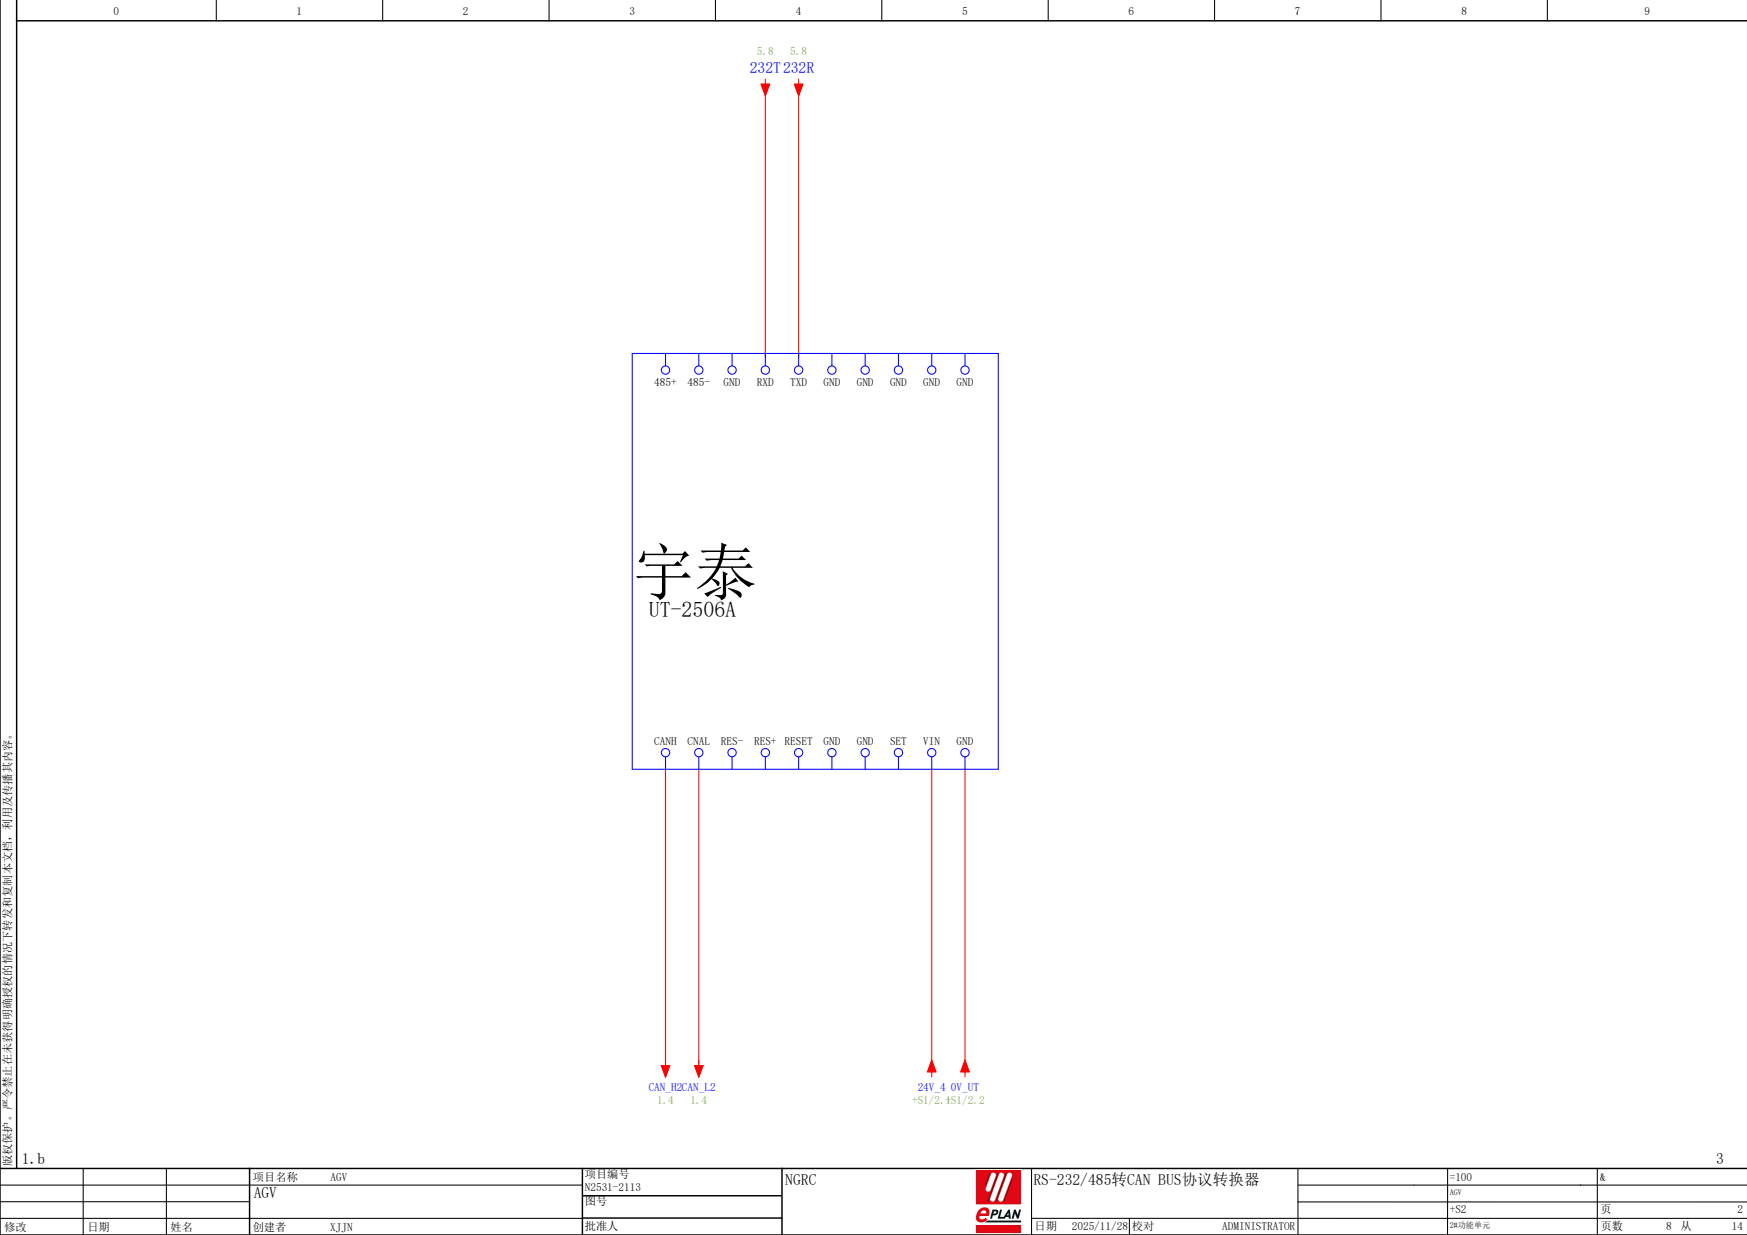
[picture p47: page 8]
RS-232/485转CAN BUS协议转换器; GND; RXD; TXD; CANH CNAL RES- RES+ RESET GND; SET; VIN; CAN_H2 1.4; CAN_L2 1.4

版权保护。严令禁止在未获得明确授权的情况下转发和复制本文档，利用及传播其内容。

# 中菱科技

# ZLAC8015D

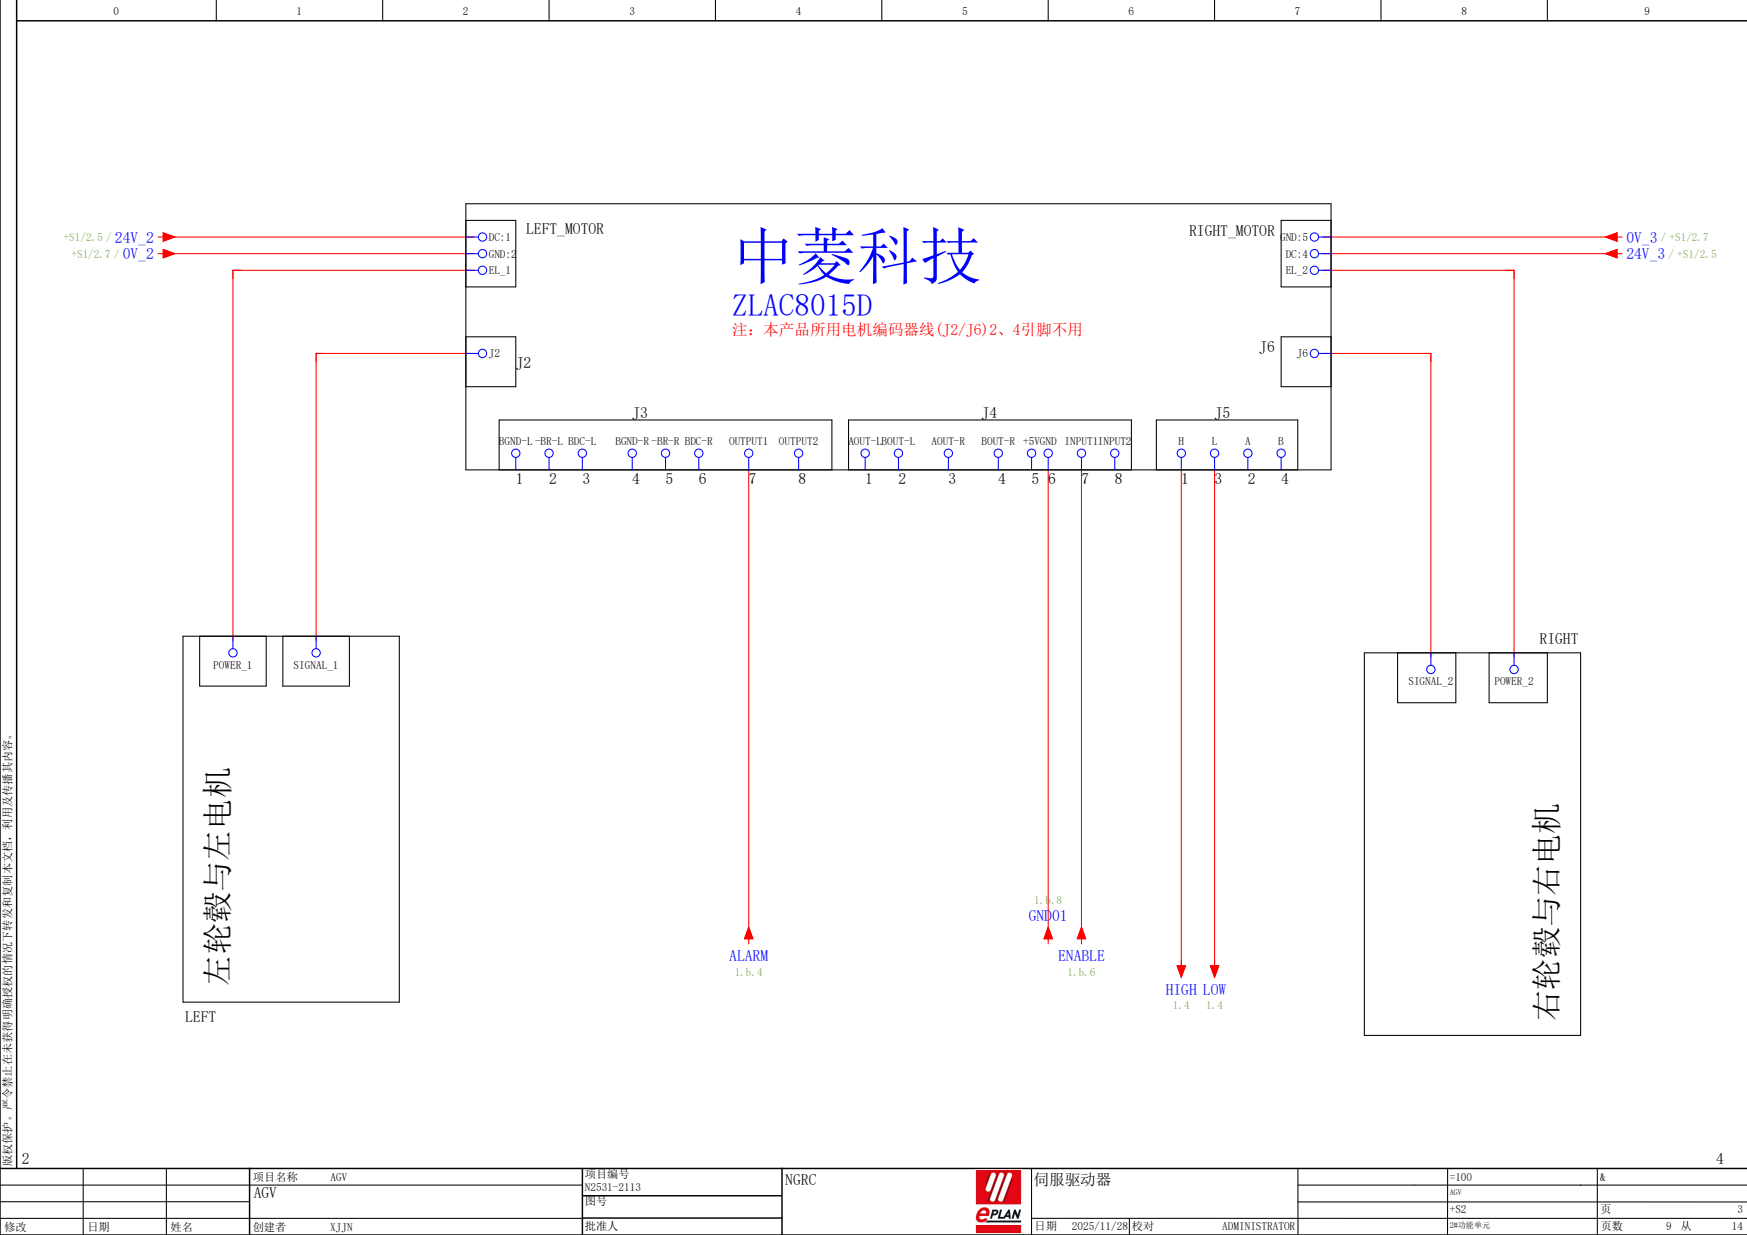
[picture p48: page 9]
伺服驱动器; 左轮毂与左电机; LEFT; POWER_1; SIGNAL_1; 右轮毂与右电机; RIGHT; SIGNAL_2; POWER_2; 注：本产品所用电机编码器线(J2/J6)2、4引脚不用; LEFT_MOTOR; RIGHT_MOTOR; GND:2; GND:5; BGND-L -BR-L BDC-L; BGND-R -BR-R BDC-R; OUTPUT1 OUTPUT2; AOUT-LBOUT-L; AOUT-R; BOUT-R +5VGND INPUT1INPUT2; HIGH; LOW; ENABLE; ALARM; GND01

版权保护。严令禁止在未获得明确授权的情况下转发和复制本文档，利用及传播其内容。

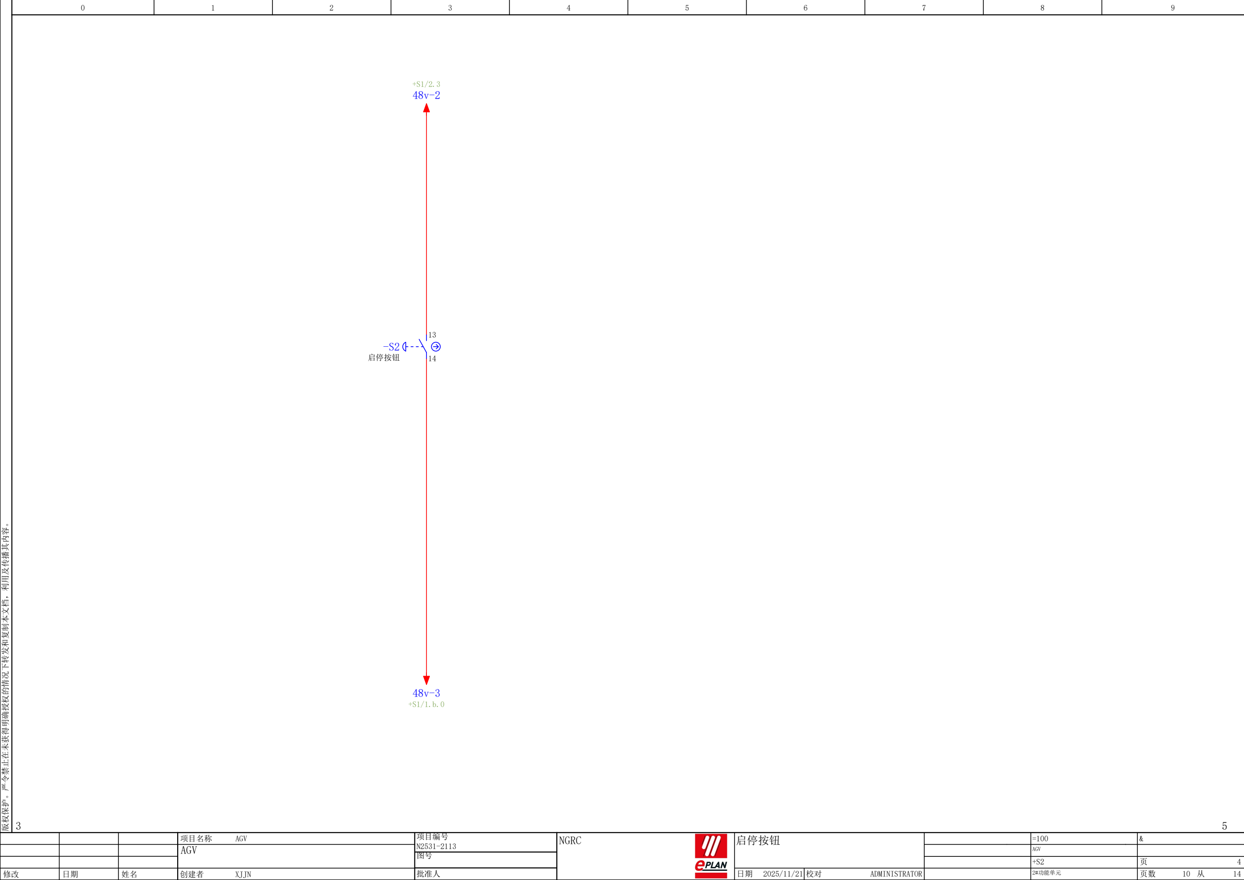
[picture p49: figure]
ADMINISTRATOR 1; 启停按钮; 版权保护。严令禁止在未获得明确授权的情况下转发和复制本文档，利用及传播其内容。

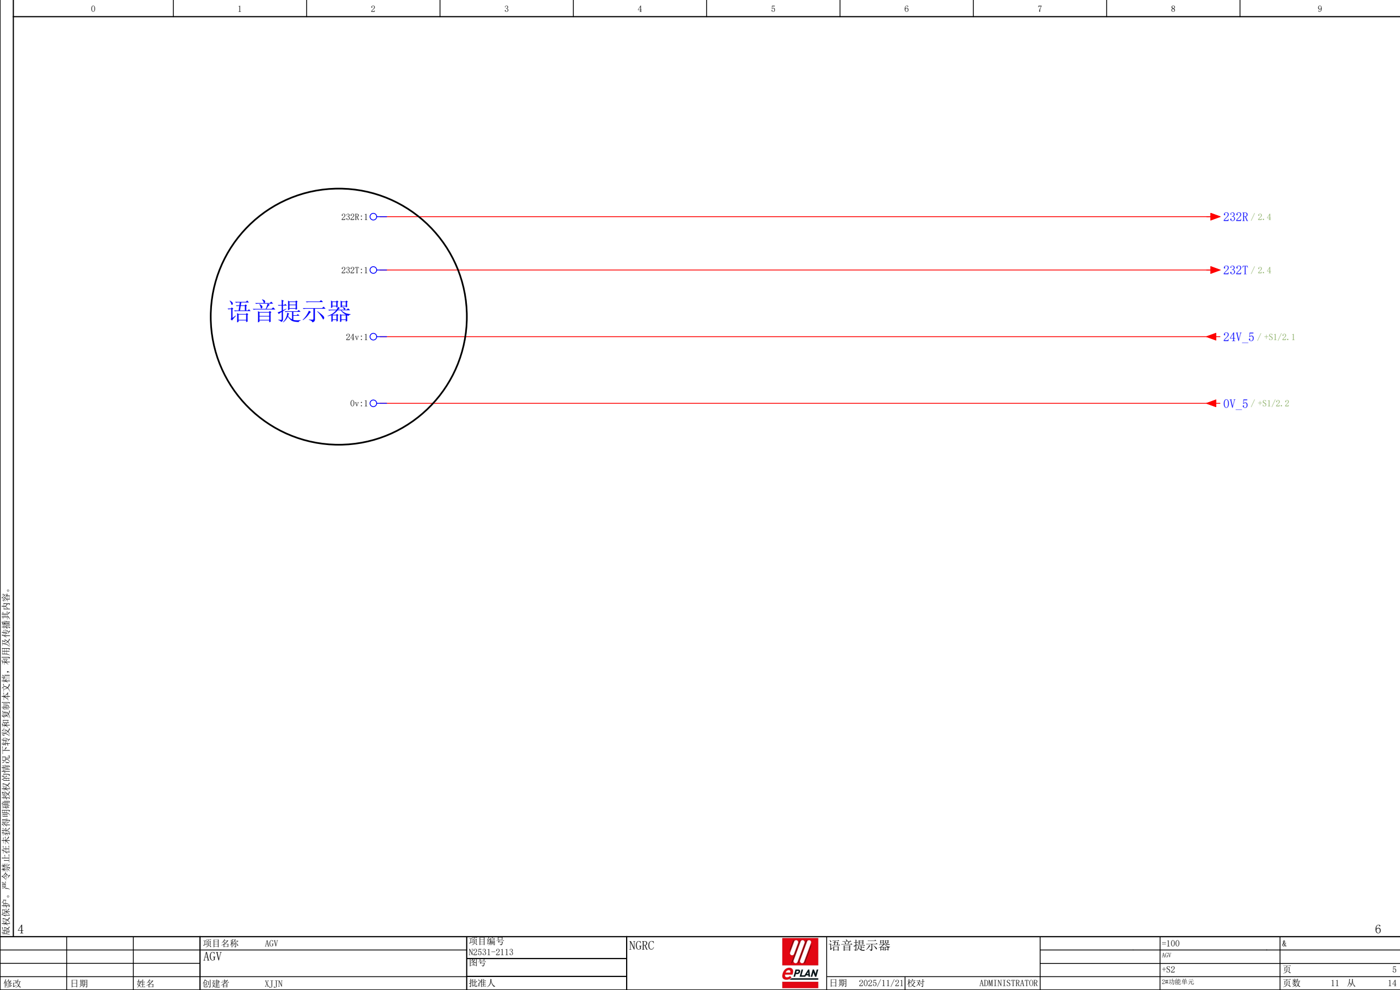
[picture p50: figure]
ADMINISTRATOR 1; 语音提示器; 版权保护。严令禁止在未获得明确授权的情况下转发和复制本文档，利用及传播其内容。

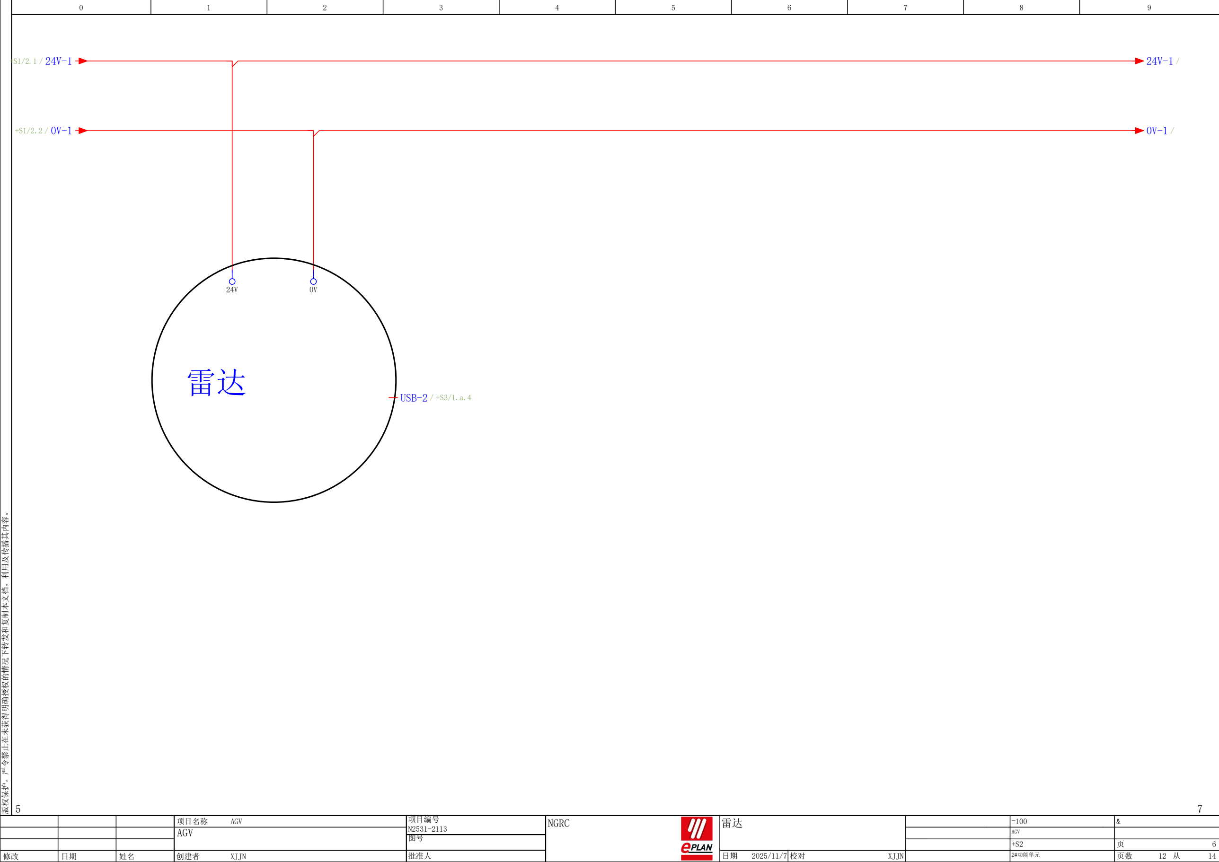
[picture p51: figure]
XJJN 1; 版权保护。严令禁止在未获得明确授权的情况下转发和复制本文档，利用及传播其内容。; USB-2

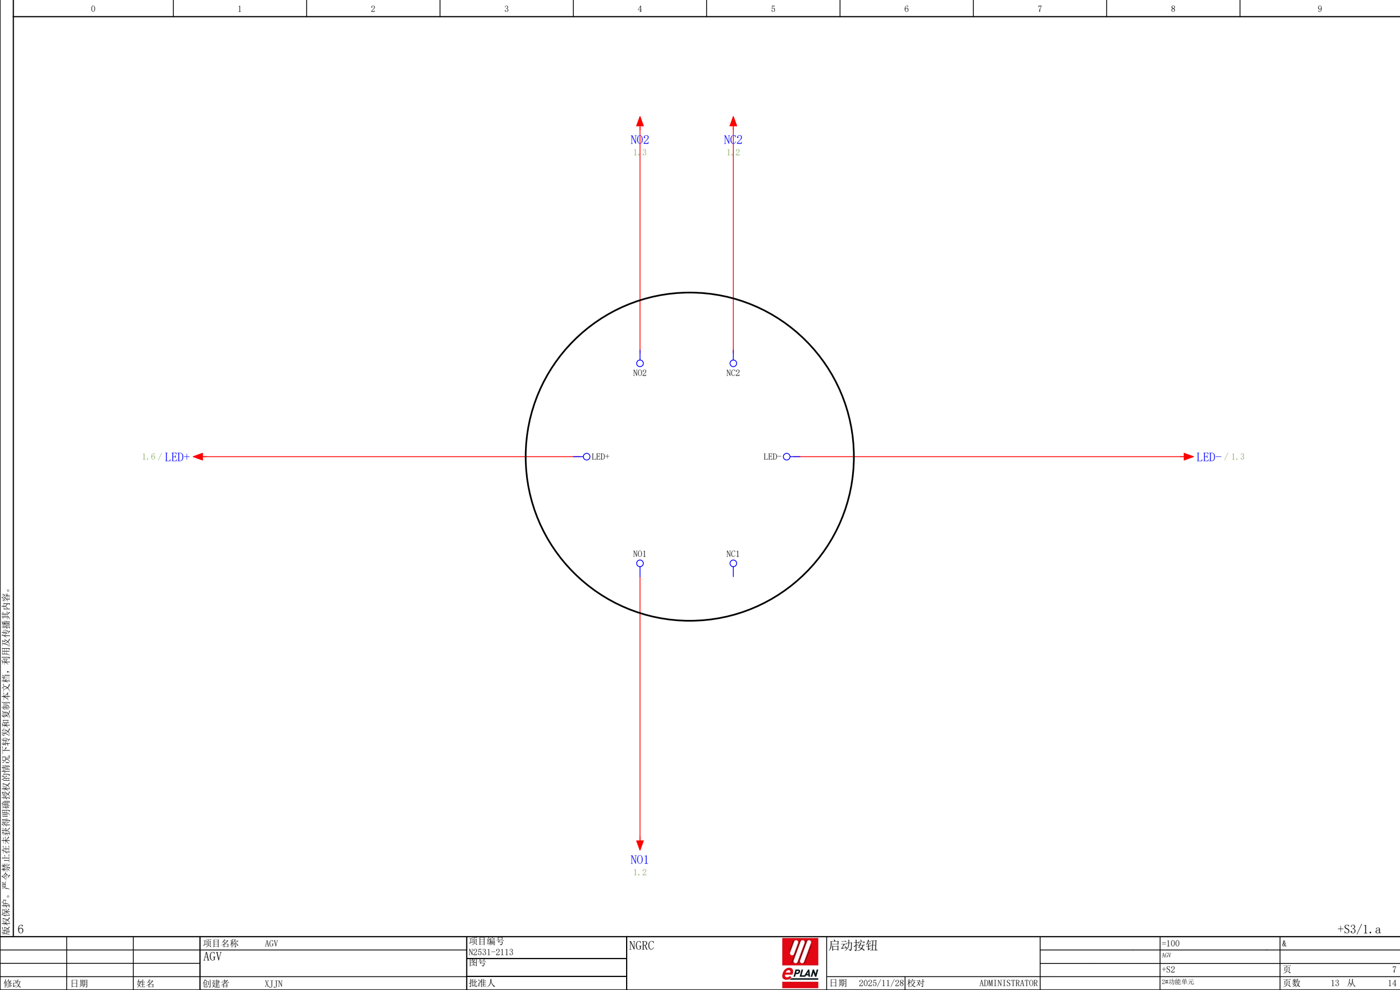
[picture p52: figure]
ADMINISTRATOR 1; 启动按钮; 版权保护。严令禁止在未获得明确授权的情况下转发和复制本文档，利用及传播其内容。; LED+; LED-; / LED+

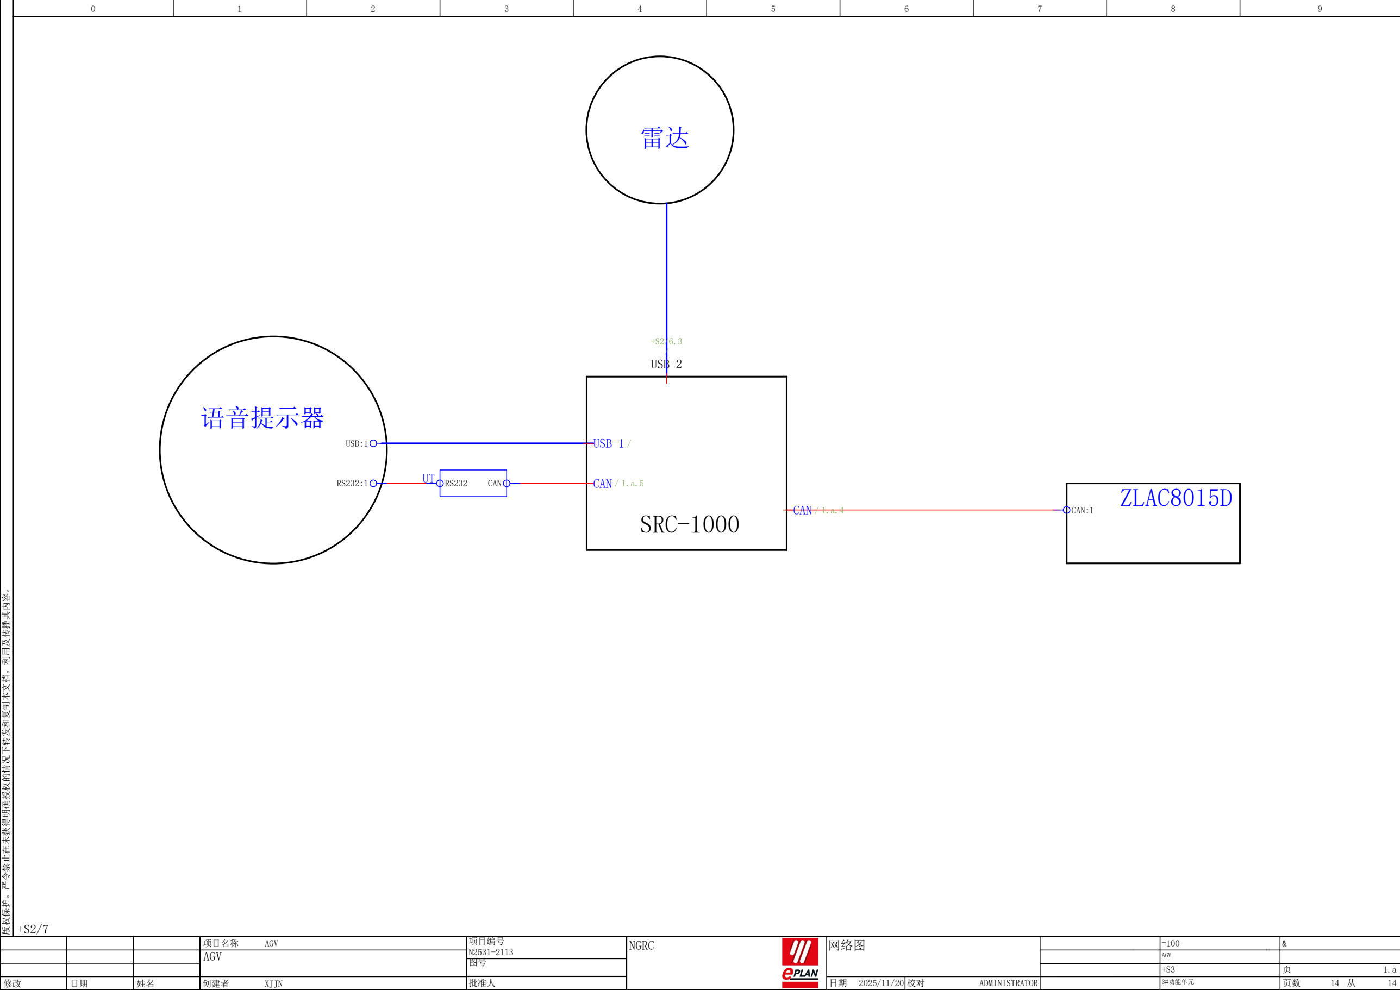
[picture p53: figure]
网络图; 版权保护。严令禁止在未获得明确授权的情况下转发和复制本文档，利用及传播其内容。; 语音提示器; ZLAC8015D; SRC-1000; USB:1; CAN:1; CAN; USB-1 /; CAN / 1.a.5; CAN / 1.a.4; USB-2
