cyx3705/2025-002/(commit log)

2026-05-08 feat:添加小AGV小车项目核心资料
    [0000-AGV-1023.cfg, 0000-AGV-1024.cfg, 0000-AGV-1024B.cfg, 0000-AGV-1026.cfg, 0000-AGV-1026B.cfg, 0000-AGV-1027.cfg, 0000-AGV-1028.cfg, 0000-AGV-1029.cfg]
2026-05-27 Sync backup - 2026-05-28 00:35
    [0000-AGV-1023.cfg, 0000-AGV-1024.cfg, 0000-AGV-1024B.cfg, 0000-AGV-1026.cfg, 0000-AGV-1026B.cfg, 0000-AGV-1027.cfg, 0000-AGV-1028.cfg, 0000-AGV-1029.cfg]
2026-06-23 一键推送更新,将原数字标号统一改为b
    [0000-AGV-1023.cfg, 0000-AGV-1024.cfg, 0000-AGV-1024B.cfg, 0000-AGV-1026.cfg, 0000-AGV-1026B.cfg, 0000-AGV-1027.cfg, 0000-AGV-1028.cfg, 0000-AGV-1029.cfg]
2026-06-27 修改导航栏和效果图
2026-08-12 一键推送更新
2026-08-14 chore: 迁移到 HistoryClio 后的工作区基线
    分仓库迁移遗留在工作区的改动一次性落库，并清理模板带下来的 Unused 脚手架。
    - 其余为迁移过程产生的工作区差异，未逐条审阅业务含义。
    本次由 Claude 代为提交，用于把分仓库后的工作树归零。
2026-09-21 LFS 修复：178 个不足 100MB 的文件转回普通入库（第 1/1 批）
    [0000-DJJ-12-5.stp, 3237440921横向刷块.STEP, MCADPP0003365_3D-simplified.stp]
2026-10-10 大扫除：移出资料大文件、清理模板残留、视频压到 1080p
    为改写历史前的黄金水位线。
2026-10-23 README：保留内容对齐模板（logo与作者）
    Claude-Session: https://claude.ai/code/session_01UZ5WhpwWxzS9khp6UQSn2P
